gionix38/tevo-bw-pick-and-place/pnp/out/render/bridgeend.png

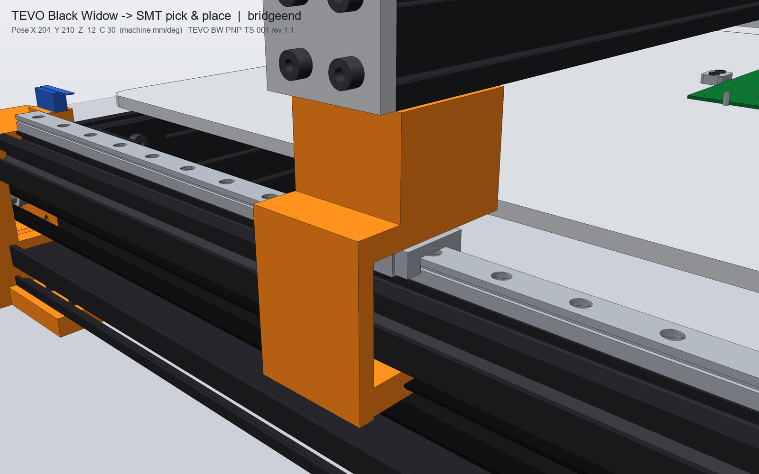
pnp/out/render/bridgeend.png
