gionix38/tevo-bw-pick-and-place/pnp/out/render/front.png

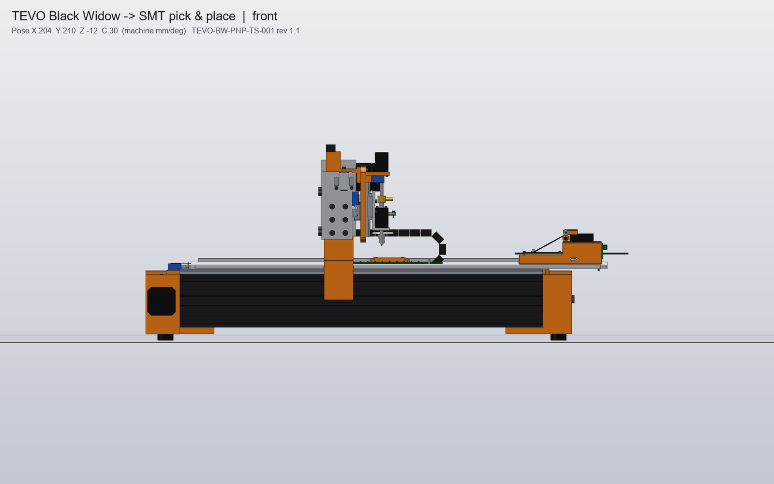
pnp/out/render/front.png
