gionix38/tevo-bw-pick-and-place/docs/i18n/ru/README.md

# Переоборудование TEVO-BW в установщик компонентов

Инженерный проект по переоборудованию 3D-принтера TEVO Black Widow в настольный станок для установки SMT-компонентов. В проект входят параметрические модели FreeCAD, конструкция питателя TBW-Feeder v3.0, инструкции по сборке, предварительные электрические схемы и ведомости материалов (BOM).

> **Состояние проекта:** прототипная конструкция. Проверки CAD и схемы не подтверждают безопасность или работоспособность собранного станка. Перед эксплуатацией проверьте совместимость с реальной рамой, проводку и защиту, пределы перемещения и работу питателя.

## Основные документы

- [Полный иллюстрированный сборник (PDF, 82 страницы)](../../../pnp/out/TEVO_BW_PnP_Dossier.pdf)
- [Руководство по сборке станка](../../../pnp/BUILD_AND_ASSEMBLY.md)
- [Отчёт по текущей CAD-модели](../../../pnp/out/report.md)
- [Архитектура питания и подробная проводка](../../../pnp/electronics/POWER_CONTROL_DESIGN.md)
- [Питатель TBW v3.0](../../../pnp/feeder/README.md)
- [Основная ведомость материалов](../../../pnp/out/bom.csv)

## Состав проекта

- Параметрическая модель станка для FreeCAD и скрипты построения.
- Механическая конструкция портала, головки, рабочего стола и приводов.
- Восьмипозиционный питатель с пошаговой подачей ленты и узлом снятия покровной плёнки.
- Предварительная архитектура питания 24 В, компьютер управления, камеры и контроллеры.
- Сборочные схемы, рендеры, отчёты и предварительные BOM.

## Сборка CAD

Установите FreeCAD 1.1. В PowerShell выполните:

```powershell
cd pnp
.\pnp.ps1 build
.\pnp.ps1 check
.\pnp.ps1 all
```

Проверка модели охватывает заданные положения в CAD, но не подтверждает геометрию реального принтера, электробезопасность или производительность. Для OpenPnP сейчас рекомендуется компьютер x86-64; Raspberry Pi описан как вспомогательный/экспериментальный вариант до проверки ARM64-сборки и работы камер.

Подробные исходные руководства и PDF-сборник пока на английском языке. Этот перевод — краткое описание и указатель по проекту.

## Лицензия и сторонние файлы

Общая лицензия на репозиторий пока не назначена. В отдельных папках находятся сторонние CAD-модели и изображения с отдельными или неясными условиями лицензирования. Перед распространением или коммерческим использованием проверьте происхождение и лицензии этих материалов.
