gionix38/tevo-bw-pick-and-place/pnp/electronics/POWER_CONTROL_DESIGN.md

# TEVO-BW — силовой блок и компьютер управления (концепт A)

Редакция 0.1 · 31.10.2026 · компоновка для текущей модели машины и feeder v3.0

## Решение

- **Основной DC источник:** Mean Well LRS-350-24, 24 V / 14.6 A / 350.4 W, только после сверки фактических токов драйверов, насоса и клапанов. Текущий CAD-проект считает динамику XY для 24 V; это не доказывает, что имеющаяся donor-плата или моторы рассчитаны на такую шину.
- **Компьютер OpenPnP:** x86-64 mini-PC с Linux 64-bit — рекомендуемый производственный host. Официальные OpenPnP Linux packages указывают x86/x64, не ARM64.
- **Raspberry Pi 5:** можно установить Raspberry Pi OS 64-bit Desktop и оставить Pi как вспомогательный компьютер/логгер. Запуск OpenPnP на ARM64 считать экспериментом: он требует сборки/проверки Java-приложения, нативного захвата камер, двух UVC-потоков и USB serial. Orange Pi имеет ту же ARM64 оговорку.
- Host получает отдельное штатное питание. Для Pi 5 это официальный USB-C БП 27 W (5 V / 5 A); не подключать 24 V к GPIO/USB-C и не питать SBC через неизвестный buck.
- **Feeder:** штатный Arduino Nano по USB как отдельный USB/serial-контроллер; сервошина 5 V от собственного DC/DC 24→5 V, не от Pi/Nano/USB. Общий GND логики и сервоприводов соединить одной точкой у feeder controller; исключить обратную подачу питания в USB перемычкой IO-shield.
- **Драйверы движения:** существующая donor-плата и её драйверы, на отдельной защищённой 24 V ветви, если это подтверждено паспортами. Сигналы шаг/направление и E-stop согласовать с фактической платой.

Корпус предусматривает место для Pi 5 как вспомогательной платы, но OpenPnP в производственной конфигурации размещается на x86-64 host. Перенос OpenPnP на Pi/Orange Pi допускается после успешной сборки ARM64 и теста обеих камер, USB-serial motion board/feeder, стабильности изображения и задержки управления.

## Однолинейная схема

```text
230 VAC* → вводной разъём/выключатель → вводная защита → распределительная колодка
                                                   ├─ AC → LRS-350-24 → DC распределитель 24 V
                                                   │                    ├─ предохранитель → motion board / drivers / motors
                                                   │                    ├─ предохранитель → pump (если 24 V) / vacuum valve
                                                   │                    ├─ DC/DC 24→5 V, ≥8 A → servo rail, 8 lanes
                                                   │                    └─ DC/DC 24→5 V, ≥2 A → Nano logic* / sensors (если не USB)
                                                   └─ AC → официальный 27 W USB-C PSU → Raspberry Pi 5

PE ──────────────── корпус/дверь, DIN rail (если проводящий), PE stud БП
E-stop (2 NC контакта) → safety relay/contactor: разрыв 24 V приводов + аппаратный DRIVER_EN
Pi остаётся запитан для логирования; остановка движения не должна зависеть от Linux/OpenPnP.
```

`*` 230 VAC показано как проектное допущение. Проверить местное напряжение, класс защиты источников, разъём, защиту и правила монтажа. Не проводить сетевую часть на печатной плате и не оставлять открытые клеммы. Сетевые работы поручить квалифицированному электрику. PE не коммутировать предохранителем или E-stop. Номинал ввода, автомата, кабеля, контактора, клемм и ответвительных предохранителей выбрать по паспортам нагрузки, способу прокладки и местным нормам; этот документ намеренно не назначает их на глаз.

## DC ветви и расчётный бюджет

| Ветвь | Проектное решение | Проверка до заказа |
|---|---|---|
| 24 V motion | Отдельный fuse holder → фактическая плата и драйверы | Допуск платы/драйверов по входному напряжению; ток и суммарная мощность; фактическая PSU машины (в проекте WP0) |
| 24 V vacuum | Отдельная ветвь для насоса и нормально закрытого клапана | Паспортный пусковой ток насоса, duty cycle клапана, диод/TVS катушки по её паспорту |
| 5 V servo | DC/DC 5 V, не менее 8 A, с тепловым запасом; звезда к шине servo | Измерить пиковый ток одного серво и худший одновременный сценарий 8 дорожек; проверить просадку на дальнем servo |
| 5 V feeder logic | Nano питается по USB во время настройки; при автономном питании — выделенный защищённый DC/DC | На IO shield не соединять USB 5 V с внешней сервошиной; сверить схему конкретного shield |
| Pi 5 | Производитель рекомендует питание 5 V / 5 A и адаптер 27 W; штатный USB-C PSU | Две камеры, SSD, fan и USB hub: проверить сообщения undervoltage, ток и пропускную способность |

LRS-350-24 даёт 24×14.6 = **350.4 W** на выходе по паспорту; это предельный источник, не утверждение о потреблении машины. Сложить измеренные токи всех одновременно работающих ветвей, учесть пуск насоса и запас, после чего подобрать защиту каждой ветви и сечение. Предусмотреть не менее 20% резерва по длительной нагрузке как проектную цель; подтвердить тепловым тестом в закрытом корпусе. В текущем проекте feeder-заметка оценивает сервошину приблизительно до 1.1 A, но это прежняя оценка для одного активного серво и лёгкого удержания, а не гарантированный all-servo stall current.

## Корпус и компоновка

Предлагаемый монтажный щит **300×240×120 mm** (Ш×В×Г), IP20 внутри сухого закрытого основания станка. Перед изготовлением проверить реальные габариты LRS-350, доступ к винтам/клеммам, радиус изгиба и выделение тепла по паспорту конкретной партии. Металлический корпус предпочтителен как защитный экран; отдельная PE шпилька с шайбами-зубцами, провод двери/крышки. Пластиковый корпус требует закрытых клемм и отдельного решения по защите от прикосновения и пожара.

Зоны: сверху/слева — ввод AC и 24 V PSU; справа — защищённые DC клеммы и DC/DC; низ — PE и вводы кабеля; Pi в отдельном вентилируемом низковольтном отсеке, удалённом от 230 V и силовых моторов/драйверов. Сервошина и USB-кабели вести отдельно от моторных фаз и насоса; пересекать силовые провода под 90°. Поставить strain relief на вводах. Не ставить Pi поверх PSU/драйвера и не закрывать радиатор/активный cooler.

В комплекте находятся векторные эскизы `power_wiring.svg` и `enclosure_layout.svg`, их PNG-экспорты и редактируемый источник `render_concept.ps1`. Это концептуальные схемы/рендер компоновки, не производственный чертёж с допусками. Корпус не смоделирован в исходном FreeCAD assembly.

Подробная клеммная схема AC/PE/24 V, аварийного останова и DC/DC дана в [`WIRING_DETAILS.md`](WIRING_DETAILS.md) и `wiring_detail.svg` / `wiring_detail.png`. USB, host, камеры и распиновка Nano/servo показаны в `host_io_detail.svg` / `host_io_detail.png`. Процедура установки ОС и совместимость ПО вынесены в [`PI5_SOFTWARE.md`](PI5_SOFTWARE.md).

## Пуск и приёмка

1. Записать фото шильдиков фактической платы, драйверов, PSU, насосов, клапанов, световых колец и камер. Сверить 12/24 V до подключения.
2. С отключённой нагрузкой настроить DC/DC; измерить 24.0 V и 5.0 V на выводах нагрузки. Ограничить ток и проверить полярность.
3. Подключить только motion board; проверить E-stop аппаратно: DRIVER_EN снимается, силовая ветвь приводов отключается, Pi остаётся online.
4. Проверить Nano/servo отдельно: внешний 5 V, правильный jumper, просадку при feed всех lane, нагрев buck и кабелей.
5. На Pi установить целевой OpenPnP и провести длительный тест обеих камер, motion serial, feeder serial, USB и логирования. Записать версию ОС, OpenPnP, camera driver, latency и ошибки.
6. 30 минут при максимальном расчётном цикле: измерить температуры PSU/DC/DC/контактора, напряжения на дальнем servo и SBC; любой brownout, перегрев или сброс означает остановку и пересмотр проекта.

## Что ещё не подтверждено

- Идентичность и входное напряжение donor motherboard/stepper drivers.
- Точные токи моторов, вакуумного насоса, клапанов, кольцевого света, камер и всех сервоприводов.
- Совместимость выбранного SBC/ОС с OpenPnP и захватом обеих камер.
- Размещение корпуса и крепёж к реальной раме, вентиляция/температура, EMC и электрическая безопасность.
- Уставки защит, номиналы проводов/предохранителей, пригодность E-stop и safety relay.

## Источники

- [Mean Well LRS-350 datasheet](https://www.meanwell.com/Upload/PDF/LRS-350/LRS-350-SPEC.PDF) — выходные параметры и требования к охлаждению/монтажу.
- [Raspberry Pi 5 product brief](https://datasheets.raspberrypi.com/rpi5/raspberry-pi-5-product-brief.pdf) и [официальные рекомендации по питанию](https://www.raspberrypi.com/documentation/computers/getting-started.html).
- [OpenPnP camera setup](https://github.com/openpnp/openpnp/wiki/Setup-and-Calibration_General-Camera-Setup) — проверить конкретную сборку и драйвер на целевой ARM64 ОС.
