gionix38/tevo-bw-pick-and-place/pnp/out/report.md

# TEVO-BW PnP - model report

Generated by `pnp build` from `params.py`. Spec: TEVO-BW-PNP-TS-001 rev 1.1. Date: 2026-10-24 17:36.

## Envelope (TS 3, 7.1, 7.2)

| Quantity | Value |
| --- | --- |
| Frame footprint (C-beams, without drive blocks) | 574 x 560 mm |
| C-beam inner gap (measured in stock STEP) | 480 mm |
| X travel (bridge on MGN12, 10 mm rail margin) | 453.0 mm |
| Y travel (carriage on MGN12, 10 mm rail margin) | 382.6 mm |
| Z stroke / usable (FR-11 >= 35) | 40 / 35 mm |
| Z soft limit (tip 1.0 mm into compliance at PCB top) | -37.4 mm |
| Bridge beam underside | Z 153 mm (frame) |
| Table top / PCB top | Z 114.0 / 115.6 mm (frame) |
| Nozzle tip at Z home | Z 152.0 mm (frame) |
| Machine origin (nozzle home) in frame coords | (114.0, 88.7, 152.0) |

## Steps per unit (TS 8.1)

| Axis | Value |
| --- | --- |
| X, Y (GT2, 20T, 1/16) | 80.000 steps/mm |
| Z (T5x2 lead 2, 1/4) | 400.0 steps/mm |
| C (1:1, 1/16) | 8.8889 steps/deg |

## Carriage mass budget (FR-4, <= 500 g)

| Part | Group | Mass g |
| --- | --- | ---: |
| Head_Carriage | carriage | 106.6 |
| ZMotor_NEMA8_LIN30 | carriage | 60.0 |
| CMotor_NEMA8_HOLLOW30 | zslide | 60.0 |
| YBlock_A | carriage | 37.0 |
| YBlock_B | carriage | 37.0 |
| ZRail_MGN9 | carriage | 34.2 |
| ZBlock_MGN9H | zslide | 26.0 |
| Z_Slide | zslide | 25.1 |
| Head_BeltClamp | carriage | 21.7 |
| Camera_Angle | carriage | 18.8 |
| ZScrew_T5x2 | carriage | 13.9 |
| DownCam_Board | carriage | 10.0 |
| Vacuum_Swivel | zslide | 10.0 |
| DownCam_Lens_M12 | carriage | 8.0 |
| DownCam_LEDRing | carriage | 6.0 |
| ZNut_T5x2_Flange | zslide | 5.0 |
| Hollow_Shaft | rotor | 4.7 |
| DownCam_LensHolder | carriage | 4.0 |
| Juki_Holder | rotor | 3.3 |
| ZHome_Switch | carriage | 3.0 |
| Compliance_Sleeve | rotor | 2.7 |
| Nozzle_Tip_loaded | rotor | 1.5 |
| **Total moving in Y** | | **499** |
| Total without the two MGN12H blocks | | 425 |

Status: **PASS** (Z motor NEMA8_LIN30). With the stock NEMA17 40 mm on Z the total is 719 g (+220 g).
Purchased-part masses are catalogue typicals; printed parts use PETG 1.27 g/cm3 x 70% effective fill. WP4 step 6 weighs the real head.

## Reach (machine coordinates)

Nozzle reach: X 114.0..567.0, Y 88.7..471.3 (frame).

| Target | X, Y | Reachable |
| --- | --- | --- |
| lane 1 pick | 426.0, 62.5 | yes |
| lane 2 pick | 426.0, 84.5 | yes |
| lane 3 pick | 426.0, 106.5 | yes |
| lane 4 pick | 426.0, 128.6 | yes |
| lane 5 pick | 426.0, 150.6 | yes |
| lane 6 pick | 426.0, 172.6 | yes |
| lane 7 pick | 426.0, 194.6 | yes |
| lane 8 pick | 426.0, 216.6 | yes |
| magazine pocket 1 | 434.0, 288.3 | yes |
| magazine pocket 2 | 434.0, 306.3 | yes |
| magazine pocket 3 | 434.0, 324.3 | yes |
| magazine pocket 4 | 434.0, 342.3 | yes |
| magazine pocket 5 | 434.0, 360.3 | yes |
| magazine pocket 6 | 434.0, 378.3 | yes |
| up camera | 434.0, 249.3 | yes |
| PCB front-left | 136.0, 161.3 | yes |
| PCB rear-right | 296.0, 261.3 | yes |
| PCB area 200x150 far corner | 336.0, 311.3 | yes |
| down camera over lane 1 pick | 424.0, 5.5 | yes |
| down camera over lane 8 pick | 424.0, 159.6 | yes |

## Z heights (machine Z, 0 = home switch)

Lowest tip (soft limit): Z -37.4. Lowest fixed head part at home: frame Z 146.0; tallest tooling the head passes over (X < 592, feeder towers excluded): frame Z 140.8; clearance 5.2 mm.

| Operation | Z needed | Reachable with >= 1 mm margin |
| --- | ---: | --- |
| place on PCB (top) | -36.4 | yes |
| pick from tape pocket | -22.6 | yes |
| magazine engage height | -22.0 | yes |
| up-camera hover (4 mm above ring) | -31.5 | yes |

## Dynamics (PR-1..PR-4, PR-10)

Moving mass: X (bridge + head) 3.08 kg, Y (head) 0.50 kg. Profiles use catalogue kg/m (WP0 weighs the beam); motors are the stock NEMA17 40 mm, 24 V supply, required margin 2.0 on pull-out torque.

| Check | Result | Pass |
| --- | --- | --- |
| X drive: 3.08 kg at 3000 mm/s2, 400 mm/s (600 rpm) | need 0.088 N m, pull-out 0.252 N m, margin 2.9 | yes |
| X step rate at 400 mm/s | 32000 steps/s (board 40000) | yes |
| Y drive: 0.50 kg at 4000 mm/s2, 400 mm/s (600 rpm) | need 0.042 N m, pull-out 0.252 N m, margin 6.1 | yes |
| Y step rate at 400 mm/s | 32000 steps/s (board 40000) | yes |
| Z step rate at PR-3 60 mm/s (1/4, 400 steps/mm) | 24000 steps/s, board limit gives 100 mm/s | yes |
| Z drive NEMA8_LIN30 travel (slide 0.14 kg, 1500 mm/s2): 1.6 N at 1800 rpm | need 0.0014 N m, pull-out 0.0045 N m, margin 3.2 | yes |
| Z drive NEMA8_LIN30 contact (slide weight + 1.5 N compliance, slow): 2.9 N at 300 rpm | need 0.0026 N m, pull-out 0.0144 N m, margin 5.5 | yes |
| C step rate, 90 deg in 150 ms (PR-4) | 10667 steps/s peak | yes |
| PR-10 cycle estimate (avg lane -> up camera -> PCB centre -> back) | 4.97 s/part = 724 parts/h (814 with the feed done during the place) | **NO** |

Cycle breakdown: XY 1.71 s, Z 2.34 s (at 60 mm/s, from Safe Z), vision 0.25 s, vacuum 0.12 s, feed 0.55 s. **OpenPnP Safe Z = -9.2** (machine Z: tip 2 mm above the tallest tooling the head passes over). Moving between pick, camera and place at Safe Z instead of Z 0 is what makes PR-10.

## Interference check

No interference between moving and fixed parts at the checked poses.

## Custom parts (what has to be made)

| Part | Kind | Qty | Mass each g |
| --- | --- | ---: | ---: |
| Down camera angle, Al 3 mm, slotted for focus | machined | 1 | 19 |
| Nozzle magazine bar, Al 24x12, 6 pockets along Y | machined | 1 | 79 |
| Tooling plate Al 6 mm 635 x 444, PCB area + tooling strip (one piece) | machined | 1 | 4504 |
| X chain tray, Al angle 50x18x2, 495 mm | machined | 1 | 176 |
| Y idler bracket, machined Al (end plate + side flange + slotted cheeks) | machined | 1 | 140 |
| Y motor bracket, machined Al 6 mm (end plate + motor plate + side flange + gussets) | machined | 1 | 225 |
| Y tension block, steel 7x10x12, M3 tapped | machined | 2 | 9 |
| Z slide, one piece: block plate + C motor arm + nut seat (CNC Al 6061) | machined | 1 | 25 |
| Bridge end: foot + riser + belt clamp (printed PETG-CF, 100% infill) | printed | 2 | 86 |
| Corner block front-left with X motor mount (printed PETG/ASA) | printed | 1 | 325 |
| Corner block front-right (printed PETG/ASA) | printed | 1 | 179 |
| Corner block rear-left (printed PETG/ASA) | printed | 1 | 199 |
| Corner block rear-right (printed PETG/ASA) | printed | 1 | 179 |
| Cover tape waste bin (printed PETG) | printed | 1 | 27 |
| Empty-tape exit chute, 8 lanes (printed PETG) | printed | 1 | 48 |
| Feeder v3.0 cover plate, bayonet rails (printed PETG) | printed | 8 | 1 |
| Feeder v3.0 cover tape guide bar D2.9 with head, pushed into the post (printed PETG) | printed | 8 | 0 |
| Feeder v3.0 idler gear 36T m1 with axle stub (printed PETG) | printed | 8 | 2 |
| Feeder v3.0 main body (printed PETG) | printed | 8 | 35 |
| Feeder v3.0 pawl, feed + detent (printed PETG) | printed | 16 | 0 |
| Feeder v3.0 pinch axle D6 x 14, pressed into the yoke (printed PETG) | printed | 8 | 0 |
| Feeder v3.0 pinch yoke (printed PETG) | printed | 8 | 0 |
| Feeder v3.0 pinion 14T m1 with the D6 drive shaft, one part (printed PETG) | printed | 8 | 1 |
| Feeder v3.0 rack m1 on the slider (printed PETG) | printed | 8 | 0 |
| Feeder v3.0 roller body, drive + pinch (printed PETG) | printed | 16 | 1 |
| Feeder v3.0 servo gear sector 13T m1 on the spline (printed PETG, replaces the horn) | printed | 8 | 0 |
| Feeder v3.0 side plate (printed PETG) | printed | 8 | 13 |
| Feeder v3.0 slider (printed PETG) | printed | 8 | 4 |
| Head belt clamp + Y chain post (printed PETG-CF) | printed | 1 | 22 |
| Head carriage plate: block mount + Z rail + Z motor shelf (printed PETG-CF) | printed | 1 | 107 |
| PCB slide clamp (printed PETG) | printed | 1 | 9 |
| Reel hub / spacer (printed PETG) | printed | 8 | 4 |
| Reel rack side plate (printed PETG) | printed | 2 | 20 |
| Up camera housing, one piece (printed PETG) | printed | 1 | 25 |
| Waste bin leg (printed PETG) | printed | 2 | 3 |
| X chain arm (printed PETG), on the Y motor bracket | printed | 1 | 8 |
| X chain tray bracket (printed PETG) | printed | 3 | 22 |
| X idler tension slider (printed PETG) | printed | 2 | 5 |

150 printed + 9 machined parts; 411 fasteners (see bom.csv, kind = fastener).

## Printing (printed parts)

All printed parts are orange PETG (PETG-CF for the head parts). STLs in `parts_stl/` are already turned to the print orientation below and lie on Z = 0. Horizontal holes over 5.2 mm diameter have a 45 deg teardrop roof (no support). Settings: 0.2 mm layers, 4 perimeters, 5 top/bottom layers, 40% gyroid, elephant-foot compensation 0.2 mm, no supports. Bed check: 220 x 220 x 250 mm.

| Part | Qty | Orientation (bed face) | Size on bed mm | Bed contact mm2 | Overhang mm2 | Flat bridge mm2 | Teardrops | Fits |
| --- | ---: | --- | --- | ---: | ---: | ---: | ---: | --- |
| Corner_FrontLeft | 1 | +Z up (as installed) | 104 x 104 x 96 | 8557 | 0 | 596 | 29 | yes |
| Corner_RearLeft | 1 | +Z up (as installed) | 104 x 68 x 90 | 6685 | 0 | 596 | 22 | yes |
| Corner_FrontRight | 1 | +Z up (as installed) | 100 x 68 x 90 | 6413 | 0 | 610 | 15 | yes |
| Corner_RearRight | 1 | +Z up (as installed) | 100 x 68 x 90 | 6413 | 0 | 610 | 15 | yes |
| XIdler_Slider_Front | 2 | +Z up (as installed) | 22 x 21 x 28 | 161 | 0 | 0 | 0 | yes |
| Bridge_End_Front | 2 | on the -X face | 91 x 64 x 44 | 2567 | 0 | 0 | 12 | yes |
| XChain_Arm | 1 | on the -Y face | 28 x 17 x 56 | 371 | 8 | 0 | 0 | yes |
| Head_Carriage | 1 | on the -X face | 114 x 128 x 44 | 14446 | 0 | 0 | 1 | yes |
| Head_BeltClamp | 1 | on the -Y face | 52 x 47 x 24 | 1037 | 0 | 0 | 0 | yes |
| PCB_SlideClamp | 1 | +Z up (as installed) | 60 x 30 x 8 | 1683 | 0 | 0 | 0 | yes |
| UpCam_Housing | 1 | +Z up (as installed) | 48 x 48 x 42 | 2240 | 0 | 36 | 0 | yes |
| Lane*_Body | 8 | on the +Y face | 127 x 66 x 20 | 4142 | 0 | 88 | 0 | yes |
| Lane*_SidePlate | 8 | on the -Y face | 127 x 61 x 16 | 3385 | 0 | 149 | 0 | yes |
| Lane*_CoverPlate | 8 | +Z up (as installed) | 62 x 18 x 10 | 973 | 0 | 0 | 0 | yes |
| Lane*_Slider | 8 | +Z up (as installed) | 85 x 14 x 17 | 619 | 0 | 31 | 0 | yes |
| Lane*_Pawl_1 | 16 | on the -Y face | 12 x 8 x 2 | 48 | 0 | 0 | 0 | yes |
| Lane*_ServoGear | 8 | +Z up (as installed) | 11 x 12 x 5 | 68 | 0 | 10 | 0 | yes |
| Lane*_Rack | 8 | on the -Y face | 15 x 12 x 3 | 142 | 0 | 17 | 0 | yes |
| Lane*_Idler | 8 | on the +Y face | 38 x 38 x 4 | 999 | 0 | 0 | 0 | yes |
| Lane*_Pinion | 8 | on the -Y face | 16 x 16 x 18 | 136 | 0 | 0 | 0 | yes |
| Lane*_DriveRoller | 16 | on the -Y face | 15 x 15 x 12 | 102 | 0 | 0 | 0 | yes |
| Lane*_PinchAxle | 8 | on the -Y face | 6 x 6 x 14 | 28 | 0 | 0 | 0 | yes |
| Lane*_PinchYoke | 8 | +Z up (as installed) | 18 x 15 x 14 | 160 | 0 | 0 | 1 | yes |
| Lane*_GuideBar | 8 | on the -Y face | 6 x 6 x 18 | 26 | 0 | 0 | 0 | yes |
| Feeder_ExitChute | 1 | on the -Y face | 21 x 17 x 178 | 325 | 4 | 258 | 5 | yes |
| Feeder_WasteBin | 1 | +Z up (as installed) | 36 x 198 x 28 | 7011 | 0 | 12 | 0 | yes |
| Feeder_WasteBinLeg_1 | 2 | on the -X face | 43 x 10 x 8 | 430 | 0 | 0 | 0 | yes |
| ReelRack_Side_1 | 2 | on the -Y face | 120 x 107 x 8 | 2827 | 0 | 0 | 0 | yes |
| ReelHub_1 | 8 | on the +Y face | 22 x 22 x 22 | 323 | 0 | 0 | 0 | yes |
| XChain_TrayBracket_1 | 3 | on the -X face | 80 x 54 x 20 | 1258 | 0 | 0 | 1 | yes |

Flat bridges left: corner-block pocket roofs (8 mm flat between 45 deg chamfers), down-facing counterbores under the feet, feeder body slider tunnel (5 / 13 mm) and pinch-yoke pocket (3.3 mm). All are within normal PETG bridging. Feeder waste bin is printed upside down; its floor bridges 34 mm.

## Design notes against the TS

- **D1** The stock C-beams are 480 mm apart (inner faces) in `Tevo Black Widow assembly.step`, not 500. The 20x80x500 top tie sits on the C-beam ends and does not fit between them; it is cut to 480. WP0 confirms.
- **D2** In the project model the 40x80x550 extrusion is the bed (Y) axis beam; the stock X gantry is two 20x40x485 bars. This model uses the 40x80x550 as the Y bridge (TS 4 item 2) and the 20x40 pair, cut to 480, as the second tie (TS 7.1).
- **D3** The bridge sits on 32 mm risers so the beam underside (Z 153) clears the tape bank, magazine and clamps. The head hangs in front of the beam (+X), so the nozzle reach is offset by 65.0 mm in X.
- **D4** The X belts run inside the open C channels; the C-beam end caps are replaced by printed drive and idler blocks. The jackshaft sits at the left end (TS 7.1).
- **D5** Head Z motor defaults to NEMA8_LIN30 to cut mass; the stock NEMA17 is the fallback named in WP4 step 6.
- **D6 (rev B)** The 20x80x210 legs are gone. Four printed corner blocks are end cap, pulley/idler housing, jackshaft bearing seat (608ZZ pressed in), tie corner bracket and leg in one; the front-left one also holds the X motor. Rubber feet screw into them.
- **D7 (rev B)** Tape lanes, up camera and nozzle magazine sit in a strip right of the bridge travel (X > 526, beam right face at most X 522), so the beam never passes over them. Tapes feed in from the right end. Magazine pockets run along Y (TS 7.5 says along X; the change is still single-axis motion).
- **D8 (rev B)** One tooling plate carries the PCB fixture and the whole tooling strip, so all feeder, camera and magazine coordinates share one datum. 3-point support: left tie + two posts on the right tie.
- **D9 (rev B)** Head = one printed head carriage (mother plate, head plate, Z motor bracket, camera bracket, switch arm, belt clamp, chain post) + one machined Z slide (Z plate, both bearing bores in one setup for FR-14, nut seat, C motor shelf). Bridge = one printed end per side (foot plate, riser, belt clamp, chain arm). The LP mother plate is no longer used.
- **D10 (rev B)** Vacuum panel and electronics box are not modelled for now; TS 7.4 and 8 still apply.
- **D11 (rev D, current head)** The head uses a NEMA8 hollow-shaft C motor and a NEMA8 external linear Z motor with integral T5x2 screw. The nozzle stack is approximately 15 g; bearing runout and loaded repeatability must be measured on the selected motor. Weigh the assembled head and verify motor torque at the actual supply voltage before setting acceleration.
- **D12 (superseded feeder history)** The v2.0/v2.1 lane used a flexure pawl and ratchet-based peel mechanism and is archived under `legacy/feeder_v2.1/`. It is not the current geometry. Current feeder details are D14 and `feeder/ASSEMBLY.md`.
- **D13 (rev F, dynamics)** (1) Aluminium profiles now carry catalogue kg/m instead of the solid-core model volume: the bridge beam was 3.6 kg in the model, ~1.3 kg in reality, so X moves 3.08 kg, not ~5.3 kg. (2) Z runs at 1/4 microstepping (400 steps/mm, 2.5 um): at 1/16 PR-3 needs 96k steps/s, over the ~40k of the 8-bit board. Configure the Z driver jumpers and Marlin DEFAULT_AXIS_STEPS_PER_UNIT to match. (3) OpenPnP Safe Z = -9.2 (tip 2 mm over the tallest tooling in reach, the magazine tips); travel at Safe Z is checked in `pnp check`. Together they bring the PR-10 estimate from ~610 to ~724 parts/h. (4) The torque checks assume a 24 V supply; at 12 V the X margin drops to ~1.9 (WP0 confirms).
- **D14 (current v3.0 feeder)** Eight independent servo lanes use a rigid spring-loaded feed pawl and detent, plus a rack/idler/pinion peel drive with two HF0612 one-way bearings per lane. The segmented cover plate is screw-locked; lane body and side plate split so PETG parts print without supports. One separate Nano controller runs the servos. This geometry is awaiting its documented physical first article; see `feeder/README.md` and `feeder/TEST.md`.
