gionix38/tevo-bw-pick-and-place/docs/i18n/PROJECT_DESCRIPTION.md

# GitHub project description

Use one of these short descriptions in the GitHub repository **About** field:

- **English:** Open CAD and build documentation for converting a TEVO Black Widow into a desktop SMT pick-and-place machine.
- **Русский:** Открытая CAD-модель и документация по переоборудованию TEVO Black Widow в настольный станок для установки SMT-компонентов.
- **Português (Brasil):** Modelos CAD e documentação para converter uma TEVO Black Widow em uma máquina pick-and-place SMT de bancada.
- **简体中文:** 将 TEVO Black Widow 改装为桌面 SMT 贴片机的开放 CAD 模型与装配文档。

Suggested repository name: `tevo-bw-pick-and-place`.
