gionix38/tevo-bw-pick-and-place/pnp/feeder/out/audit.md

# TBW-Feeder v3.0 audit

Generated by `feeder audit` on 2026-10-24 17:59.

| Area | Check | Result | Status | Note |
|---|---|---|---|---|
| geometry | static overlaps, all 30 lane parts + tape (model pose = forward end) | none | OK | press fits are modelled line-on-line |
| geometry | feed pawl and detent teeth sit in sprocket holes at the forward end | 0.000 / 0.000 mm3 | OK | detent hook face 0.15 mm behind its hole edge (back-drag play) |
| advance | servo sweep 71.5..108.5 deg (9 poses): servo gear, slider, pawl, rack, idler, pinion vs every part | free (39 pairs) | OK | rack, idler and pinion in mesh over the whole stroke; the pawl riding under the tape is checked below |
| advance | feed tooth drops into the next hole at the retract end | tooth/tape 0.000 mm3 | OK | stroke 4.2 = 4.0 feed + 0.2 free travel |
| peel | rack/idler and idler/pinion engaged at both stroke ends (moved 0.6 mm into mesh they overlap) | 2.11 / 1.51, 1.02 / 1.17 mm3 | OK |  |
| advance | feed pawl rides over: tooth 0.85 mm down (5.8 deg about the pin) / up-stop | free (0.000 mm3) / stop hit (0.11 mm3 at +0.6 deg) | OK | the tail sits on the fork floor, so the push load (self-locking) cannot lift the tooth further |
| advance | detent rides over: tooth 0.85 mm down (5.8 deg about the pin) / up-stop | free (0.000 mm3) / stop hit (0.11 mm3 at +0.6 deg) | OK | the tail sits on the fork floor, so the push load (self-locking) cannot lift the tooth further |
| peel | pinch yoke pushed down 3 mm by its rear tab (thread the cover tape) | free | OK |  |
| assembly | lay-in assembly paths (8), reverse order of ASSEMBLY.md (screws go in along their axis) | all free | OK | one direction for everything; then 3 side plate screws, the guide bar and the 2 cover plate screws |
| cover | bayonet cover plate: held at home / slides 6.8 mm to the pick side / lifts off | held / free / free | OK | 3 rail segments per side + 2 rear tongues; 2 M2 screws lock it |
| printing | Body on the +Y face: bridge / one-sided ceiling / steep overhang | 8.8 mm / 1.0 mm / 0.0 mm2 | OK | no supports: limits 10 / 1 / 3; 127 x 66 x 21 mm, bed contact 4142 mm2 |
| printing | Body thinnest wall (X/Y line sampling) | 0.90 mm at ('Y', 535.25, 9.3, 16.9) | OK |  |
| printing | SidePlate on the -Y face: bridge / one-sided ceiling / steep overhang | 6.3 mm / 1.0 mm / 0.0 mm2 | OK | no supports: limits 10 / 1 / 3; 127 x 61 x 16 mm, bed contact 3384 mm2 |
| printing | SidePlate thinnest wall (X/Y line sampling) | 0.85 mm at ('Y', 602.25, 4.7, 14.4) | OK |  |
| printing | CoverPlate +Z up (as installed): bridge / one-sided ceiling / steep overhang | 0.0 mm / 0.0 mm / 0.0 mm2 | OK | no supports: limits 10 / 1 / 3; 62 x 18 x 10 mm, bed contact 973 mm2 |
| printing | CoverPlate thinnest wall (X/Y line sampling) | 1.20 mm at ('Y', 588.25, -9.3, 24.2) | OK |  |
| printing | Slider +Z up (as installed): bridge / one-sided ceiling / steep overhang | 3.4 mm / 0.9 mm / 0.0 mm2 | OK | no supports: limits 10 / 1 / 3; 85 x 14 x 17 mm, bed contact 619 mm2 |
| printing | Slider thinnest wall (X/Y line sampling) | 0.80 mm at ('X', 556.3, 147.55, 8.6) | OK |  |
| printing | Pawl on the -Y face: bridge / one-sided ceiling / steep overhang | 0.0 mm / 0.0 mm / 0.0 mm2 | OK | no supports: limits 10 / 1 / 3; 12 x 8 x 2 mm, bed contact 48 mm2 |
| printing | Pawl thinnest wall (X/Y line sampling) | 0.84 mm at ('X', 557.4, 148.1, 15.3) | OK |  |
| printing | ServoGear +Z up (as installed): bridge / one-sided ceiling / steep overhang | 3.6 mm / 1.0 mm / 0.0 mm2 | OK | no supports: limits 10 / 1 / 3; 11 x 12 x 5 mm, bed contact 68 mm2 |
| printing | ServoGear thinnest wall (X/Y line sampling) | 2.11 mm at ('X', 606.5, 149.75, 21.7) | OK |  |
| printing | Rack on the -Y face: bridge / one-sided ceiling / steep overhang | 0.0 mm / 0.6 mm / 0.0 mm2 | OK | no supports: limits 10 / 1 / 3; 15 x 12 x 3 mm, bed contact 142 mm2 |
| printing | Rack thinnest wall (X/Y line sampling) | 1.13 mm at ('X', 626.4, 144.05, 8.7) | OK |  |
| printing | Idler on the +Y face: bridge / one-sided ceiling / steep overhang | 0.0 mm / 0.0 mm / 0.0 mm2 | OK | no supports: limits 10 / 1 / 3; 38 x 38 x 4 mm, bed contact 999 mm2 |
| printing | Idler thinnest wall (X/Y line sampling) | 1.03 mm at ('X', 631.2, 140.55, 37.2) | OK |  |
| printing | Pinion on the -Y face: bridge / one-sided ceiling / steep overhang | 0.0 mm / 0.0 mm / 0.0 mm2 | OK | no supports: limits 10 / 1 / 3; 16 x 16 x 18 mm, bed contact 136 mm2 |
| printing | Pinion thinnest wall (X/Y line sampling) | 1.35 mm at ('X', 635.0, 144.05, 58.9) | OK |  |
| printing | DriveRoller on the -Y face: bridge / one-sided ceiling / steep overhang | 0.0 mm / 0.0 mm / 0.0 mm2 | OK | no supports: limits 10 / 1 / 3; 15 x 15 x 12 mm, bed contact 103 mm2 |
| printing | DriveRoller thinnest wall (X/Y line sampling) | 0.83 mm at ('Y', 635.65, 1.3, 51.8) | OK |  |
| printing | PinchAxle on the -Y face: bridge / one-sided ceiling / steep overhang | 0.0 mm / 0.0 mm / 0.0 mm2 | OK | no supports: limits 10 / 1 / 3; 6 x 6 x 14 mm, bed contact 28 mm2 |
| printing | PinchAxle thinnest wall (X/Y line sampling) | 2.99 mm at ('X', 636.5, 144.65, 40.3) | OK |  |
| printing | PinchYoke +Z up (as installed): bridge / one-sided ceiling / steep overhang | 0.0 mm / 0.0 mm / 0.0 mm2 | OK | no supports: limits 10 / 1 / 3; 18 x 15 x 14 mm, bed contact 160 mm2 |
| printing | PinchYoke thinnest wall (X/Y line sampling) | 1.25 mm at ('X', 633.8, 156.25, 42.4) | OK |  |
| printing | GuideBar on the -Y face: bridge / one-sided ceiling / steep overhang | 0.0 mm / 0.0 mm / 0.0 mm2 | OK | no supports: limits 10 / 1 / 3; 6 x 6 x 18 mm, bed contact 26 mm2 |
| printing | GuideBar thinnest wall (X/Y line sampling) | 2.10 mm at ('X', 595.2, 143.2, 48.4) | OK |  |
| printing | printed lane parts: material / count / filament | PETG / 15 parts (13 different) / 59 g | OK | one material, one 0.4 mm nozzle; no TPU (O-rings are bought) |
| loads | pawl spring (steel, OD 3 x 0.3 x L0 8, ~0.5 N/mm): seated / riding over | 1.25 / 1.56 N | OK | solid length ~3 mm; the v2.1 flexure pawl gave 0.26 N |
| loads | pawl pivot below the tooth: the push load turns the tooth deeper (self-locking) | contact 5.9 mm above the pivot | OK | positive up-stop: the tail on the fork floor |
| loads | tape push (detent ramp + pawl friction + reel drag) / servo torque vs SG90 stall 0.18 N m | 3.8 N / 0.0244 N m | OK |  |
| loads | pawl tooth root bending (0.8 x 1.15 root, load 0.5 above it; prints lying, in-plane) | 10.7 MPa | OK | PETG ~45 MPa in the layer plane |
| loads | pinch spring / nip slip tension (NBR O-rings, mu ~0.8) | 1.50 / 1.20 N | OK | EIA-481 peel force 0.1..1.3 N |
| peel | cover tape tension held on the idle stroke (pinch roller with O-rings, locked by its HF0612) | 1.20 N | OK | = nip slip tension, so the cover tape does not slip back on the retract |
| peel | drive roller surface per full stroke (4 mm fed) / half stroke (2 mm fed) | 4.80 / 2.40 mm | OK | rack 4.2 x R 8 / R 7 (the 38T idler doesn't change it), less 0.31 mm backlash + clutch take-up; the surplus slips in the nip |
| loads | servo torque, tape + peel at nip slip vs stall 0.18 N m | 0.0343 N m (peel adds 1.5 N at the slider) | OK | the v3.0 lifter slot added 3.1 N |
| loads | pinion / idler / rack tooth bending (Lewis, 14T m1, face 1.8) | 2.8 MPa | OK | the v2.1 ratchet teeth were 0.6 mm deep |
| loads | pinion shaft (printed with the pinion, D6, bored D3.3 at the -y end) in torsion | 10 N mm, 0.25 MPa | OK | PETG creep limit ~5 MPa; no press fit left to slip |
| loads | HF0612 one-way bearings: torque / catalogue rating | 10 / ~1800 N mm | OK | on printed PETG shafts (the catalogue assumes HRC 58): TEST A10 checks the lock |
| cover | cover plate deflection under the pawl spring: rails every 14 mm vs v2.1 (screws + hinge 58 mm apart) | 0.031 mm vs 2.2 mm | OK | the v2.1 plate bowed enough to let the pawl lift the tape out of the hole |
| cover | 2 x M2 countersunk screws (self-tapped into PETG, ~40 N pull-out each) lock the plate home vs tape drag on the feed stroke | 80 N vs 0.94 N | OK | the bayonet cannot slide out while they are in: positive lock, no magnets |
| bank | chute, waste bin, reel rack vs frame, plate, lanes | none | OK |  |
| bank | empty tape drop path below the plate slot to the bench | clear | OK |  |
| bank | carrier tape path reel -> lane inlet | clear | OK |  |
| bank | used cover tape leaves the nip over the waste bin lip | clear | OK |  |

**54 OK, 0 FAIL**
