gionix38/tevo-bw-pick-and-place/pnp/electronics/enclosure_render.png

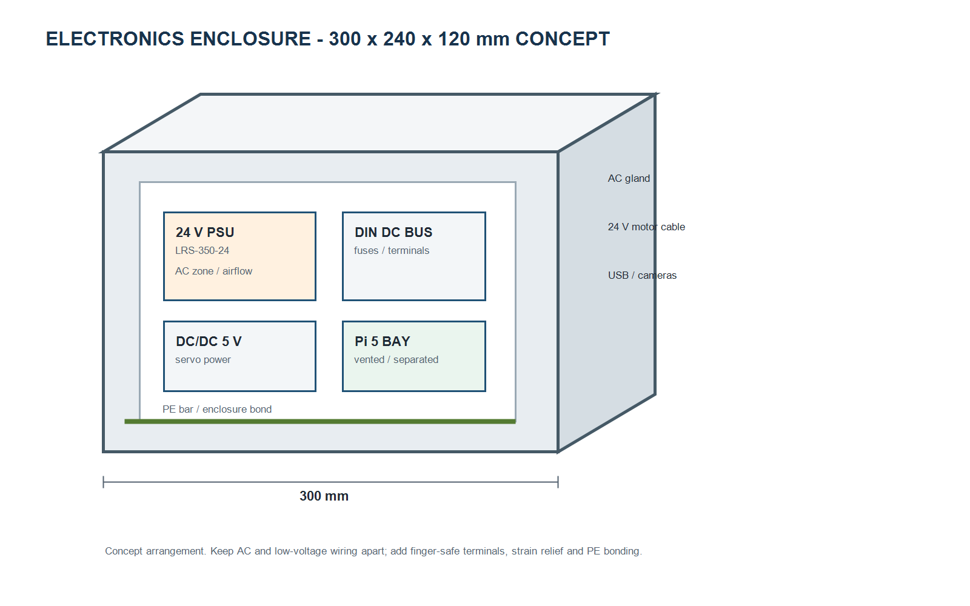
pnp/electronics/enclosure_render.png
