gionix38/tevo-bw-pick-and-place/pnp/electronics/host_io_detail.png

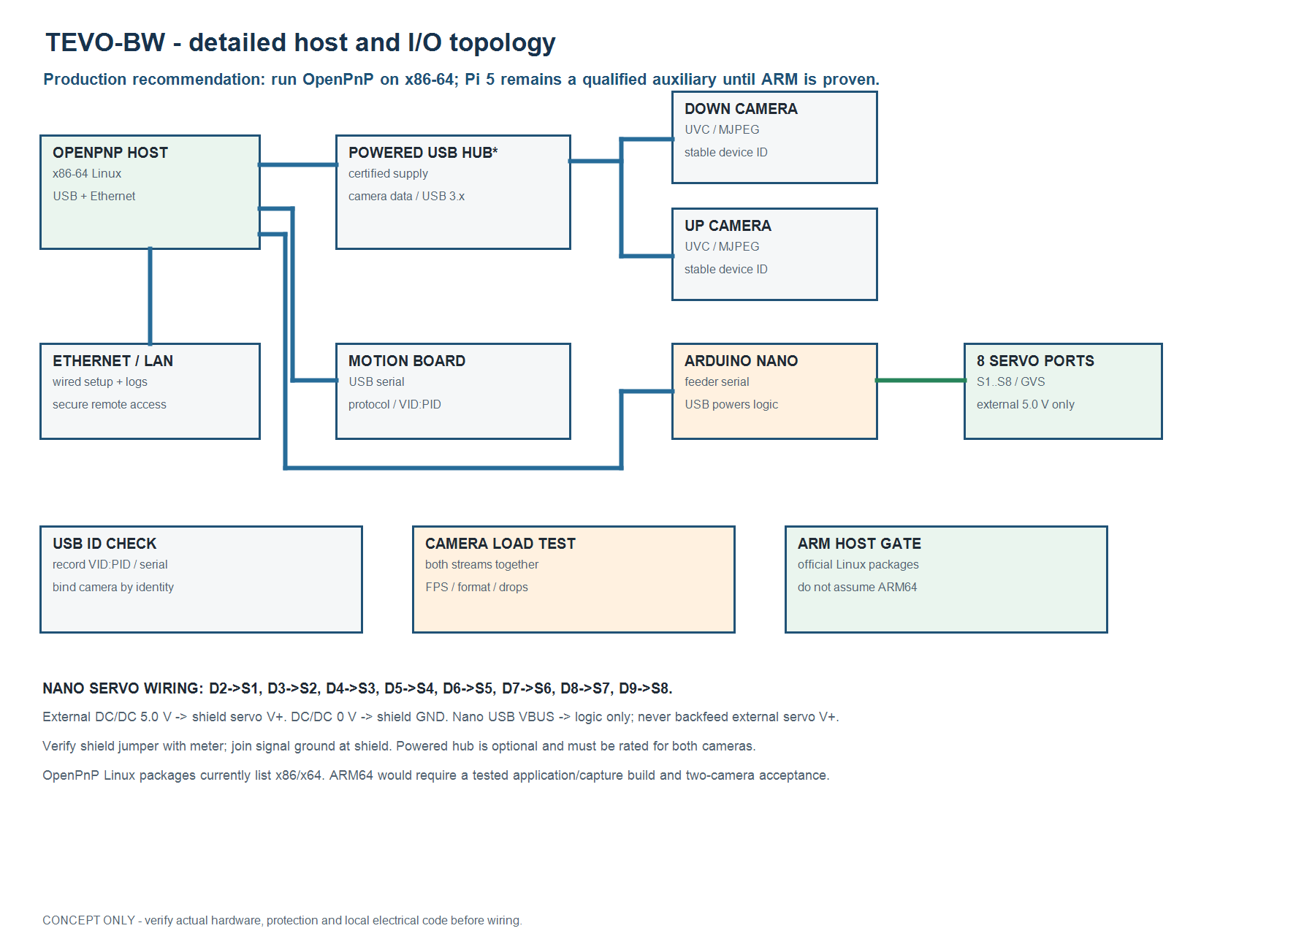
pnp/electronics/host_io_detail.png
