gionix38/tevo-bw-pick-and-place/pnp/feeder/out/feeder_animation.gif

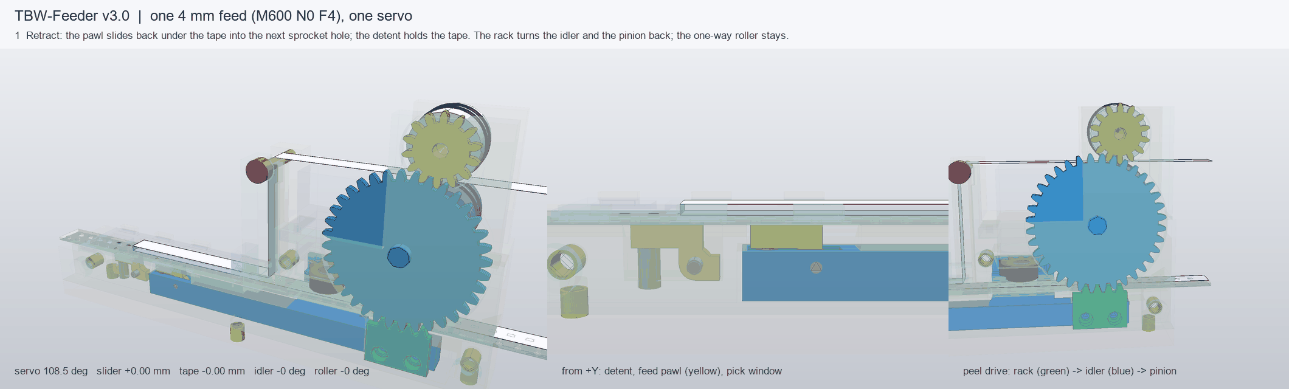
pnp/feeder/out/feeder_animation.gif
