gionix38/tevo-bw-pick-and-place/pnp/feeder/out/peel_exploded.png

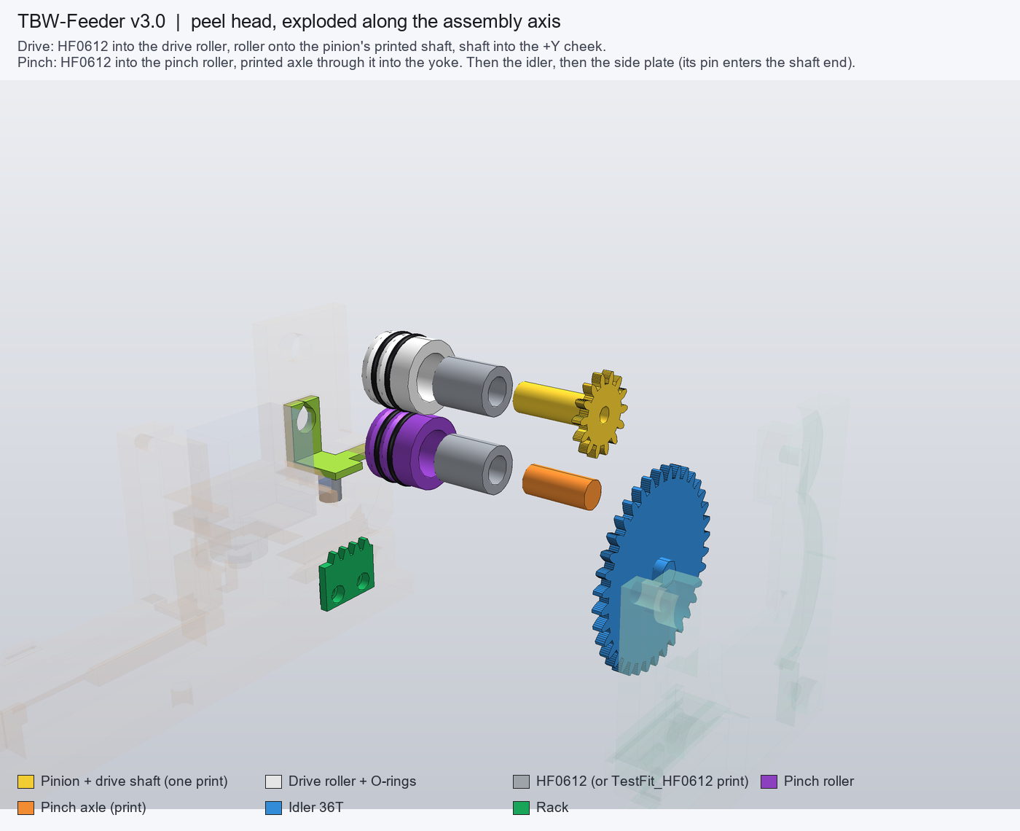
pnp/feeder/out/peel_exploded.png
