gionix38/tevo-bw-pick-and-place/pnp/out/render/camera.png

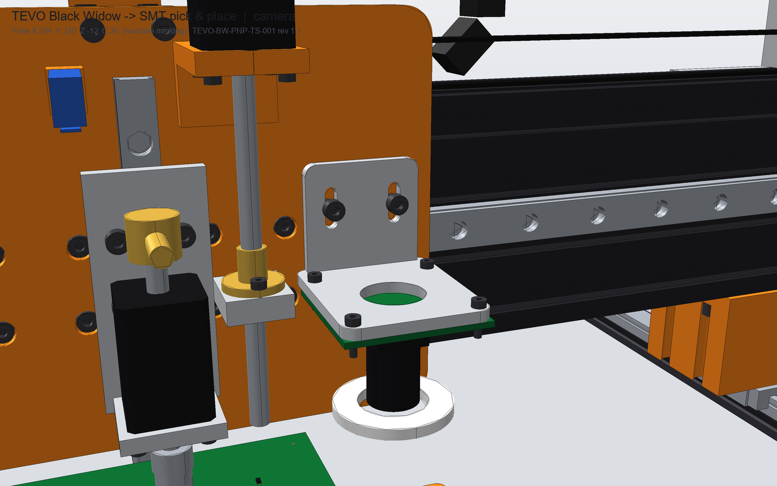
pnp/out/render/camera.png
