gionix38/tevo-bw-pick-and-place/pnp/out/render/details.png

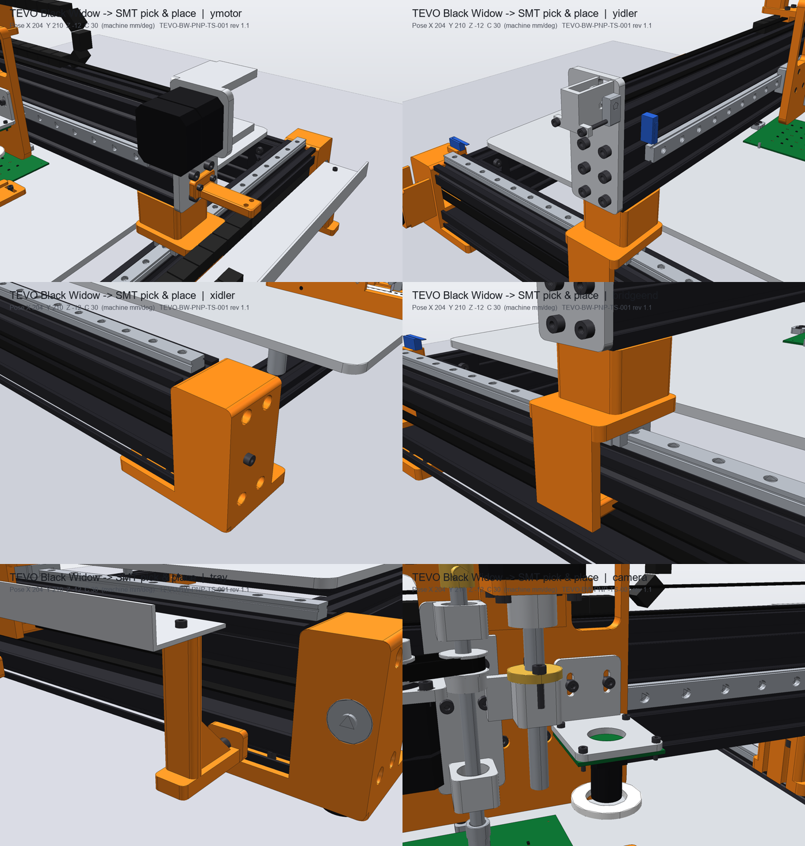
pnp/out/render/details.png
