gionix38/tevo-bw-pick-and-place/pnp/out/render/feeder.png

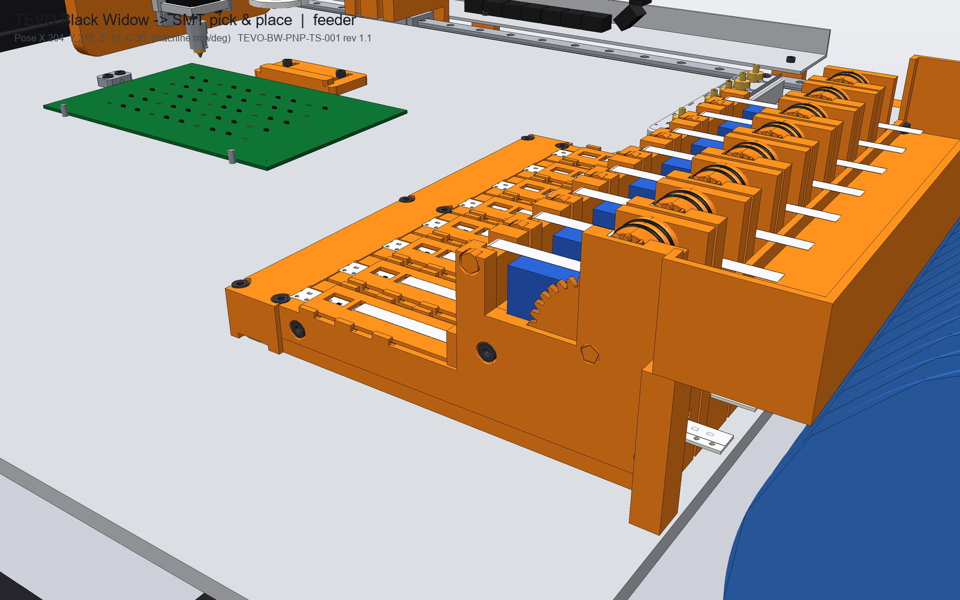
pnp/out/render/feeder.png
