gionix38/tevo-bw-pick-and-place/pnp/out/render/feeder_mech.png

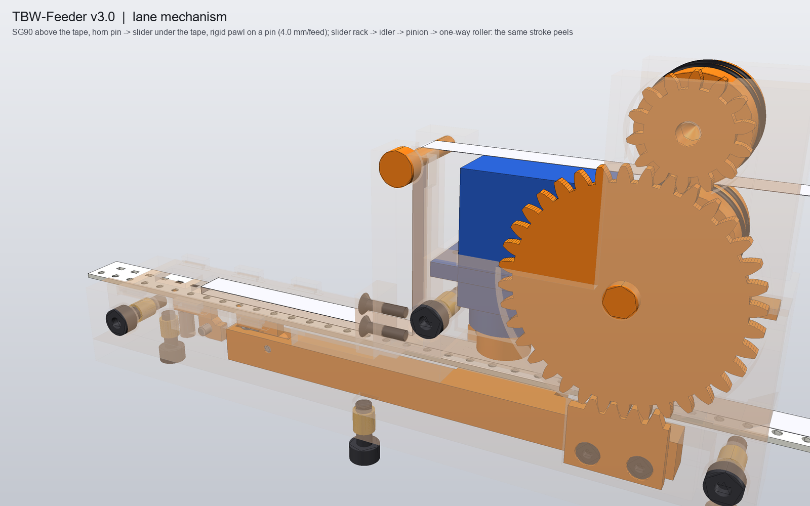
pnp/out/render/feeder_mech.png
