gionix38/tevo-bw-pick-and-place/pnp/out/render/feeder_sheet.png

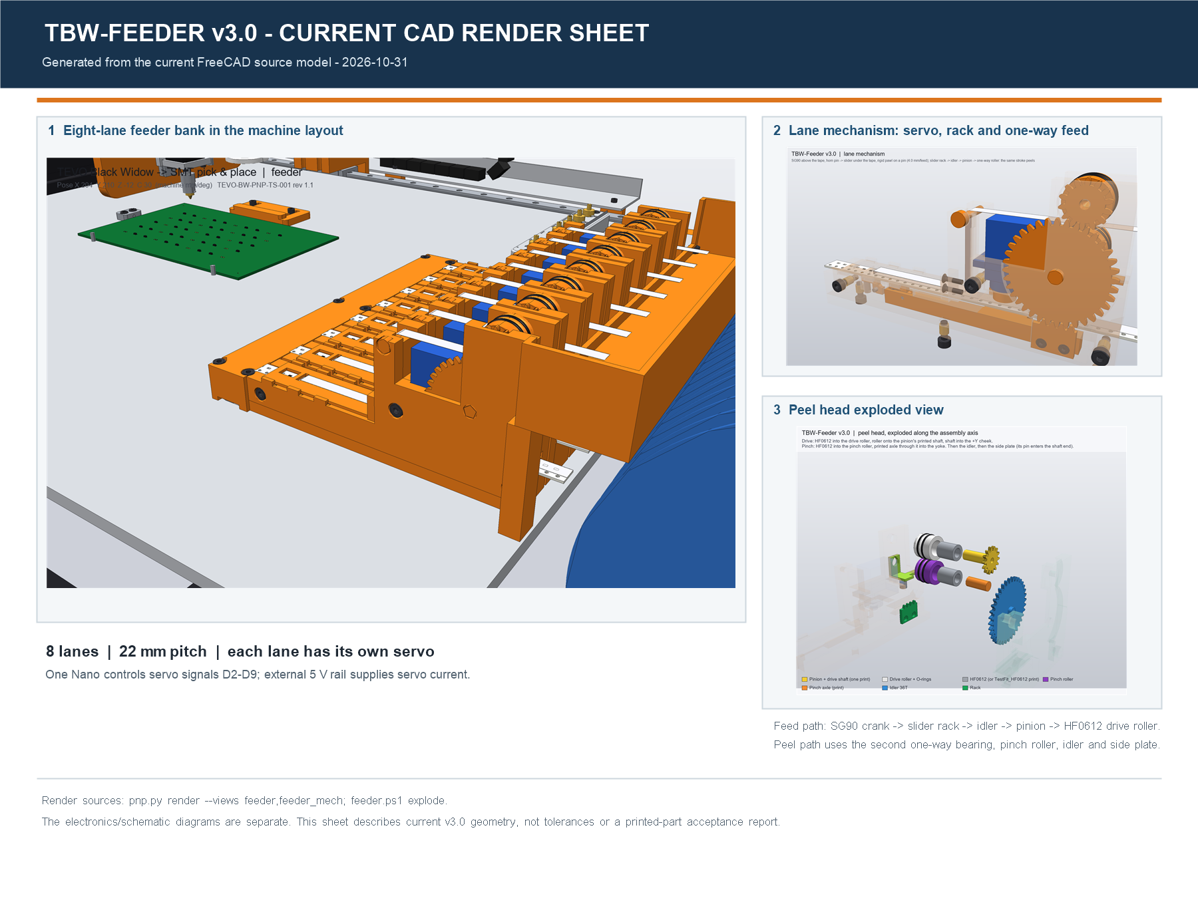
pnp/out/render/feeder_sheet.png
