gionix38/tevo-bw-pick-and-place/pnp/out/render/head.png

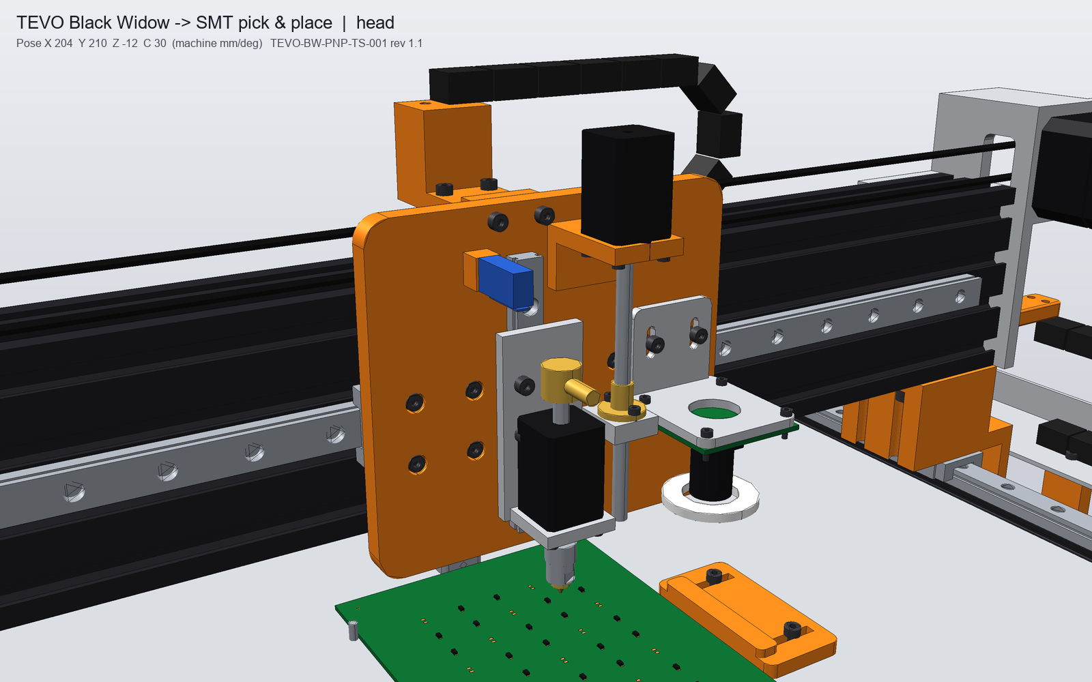
pnp/out/render/head.png
