gionix38/tevo-bw-pick-and-place/pnp/out/render/head_front.png

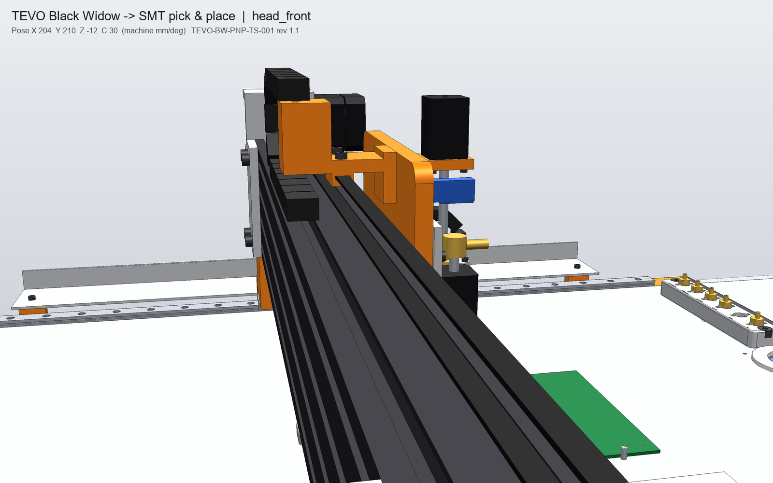
pnp/out/render/head_front.png
