gionix38/tevo-bw-pick-and-place/pnp/out/render/iso.png

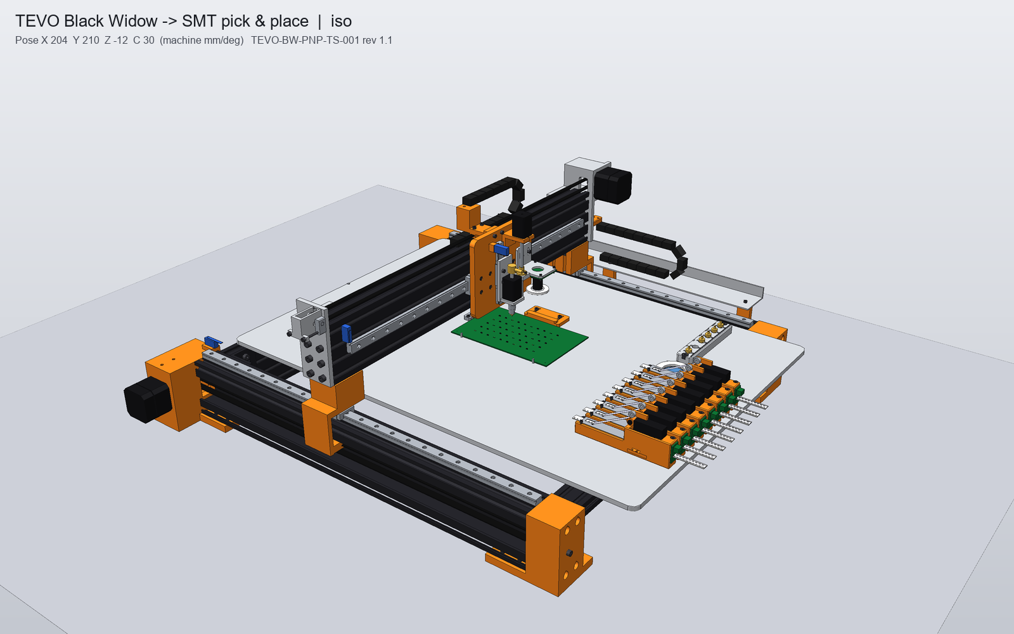
pnp/out/render/iso.png
