gionix38/tevo-bw-pick-and-place/pnp/out/render/iso_rear.png

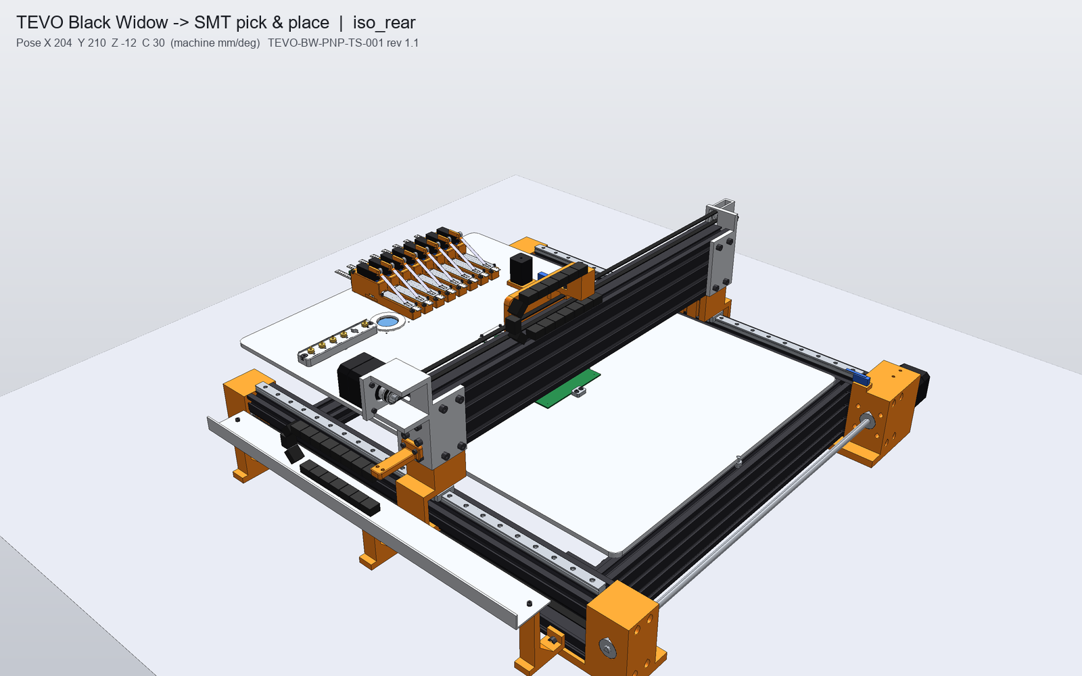
pnp/out/render/iso_rear.png
