gionix38/tevo-bw-pick-and-place/pnp/out/render/revD.png

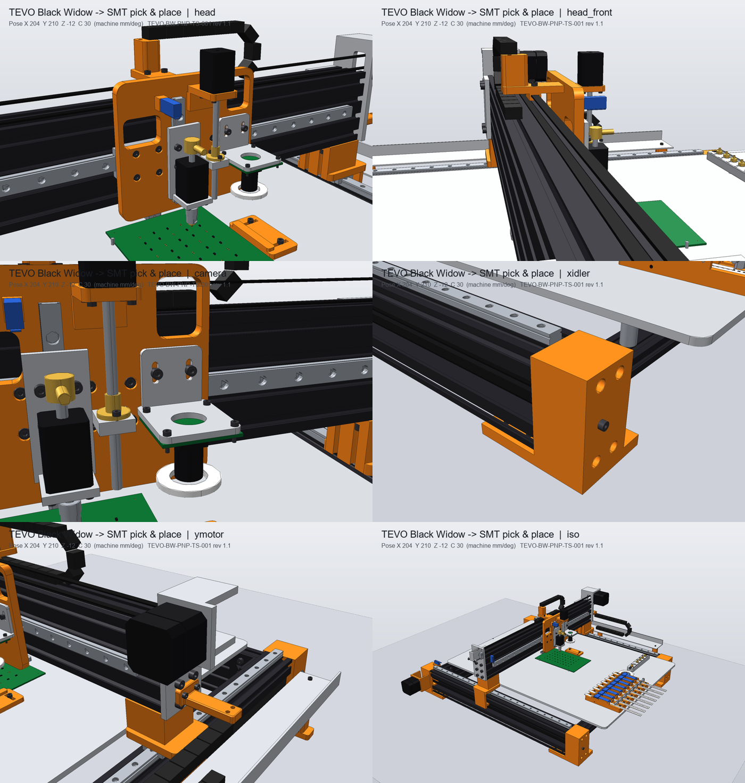
pnp/out/render/revD.png
