gionix38/tevo-bw-pick-and-place/pnp/out/render/side.png

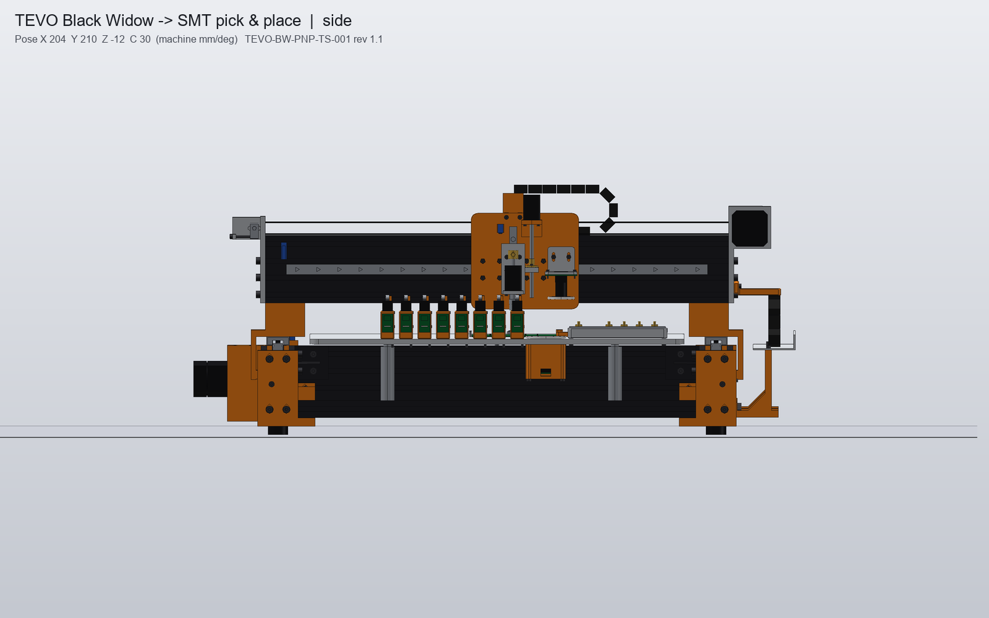
pnp/out/render/side.png
