gionix38/tevo-bw-pick-and-place/pnp/out/render/strip.png

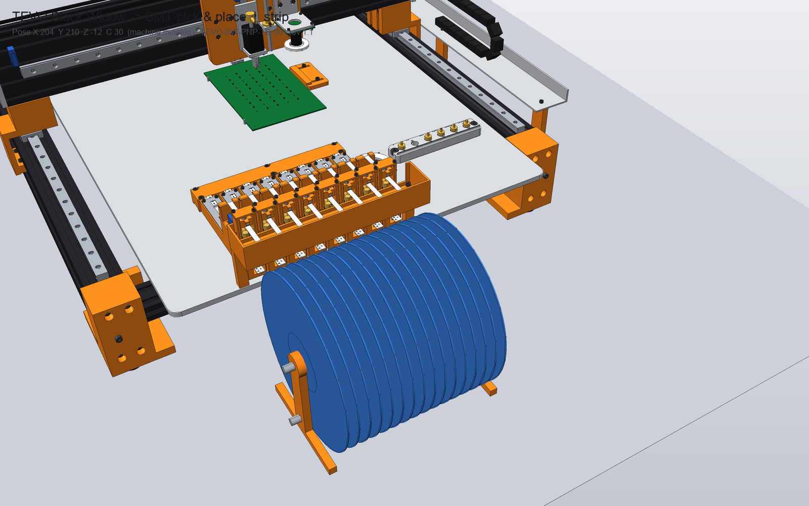
pnp/out/render/strip.png
