gionix38/tevo-bw-pick-and-place/pnp/out/render/table.png

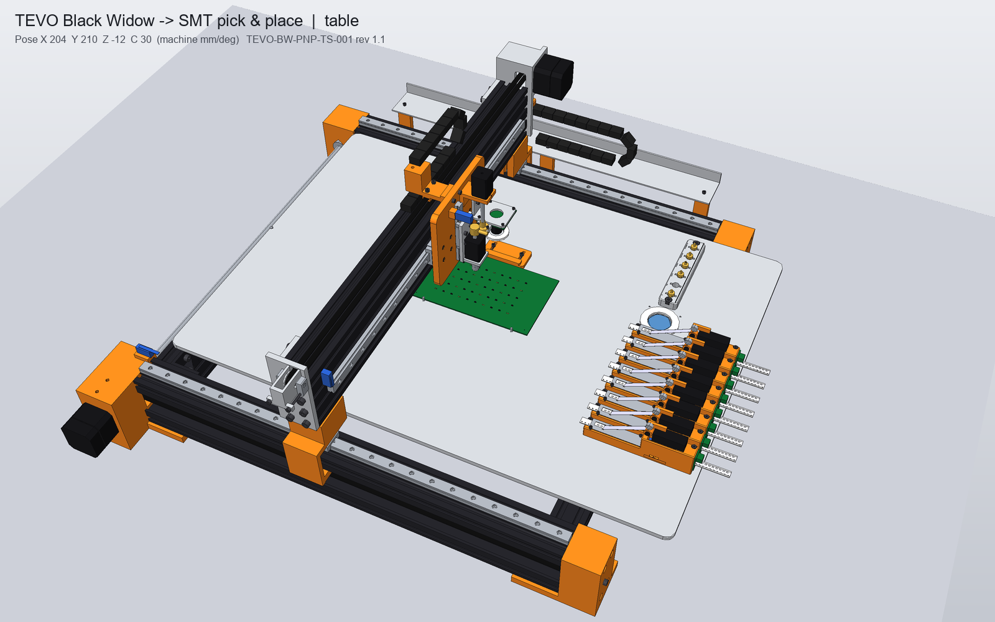
pnp/out/render/table.png
