gionix38/tevo-bw-pick-and-place/pnp/out/render/top.png

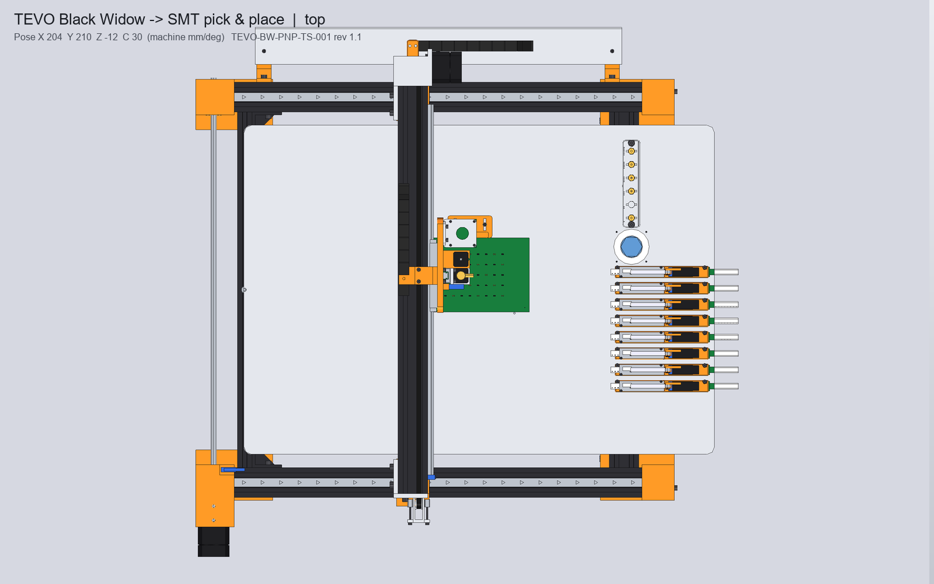
pnp/out/render/top.png
