gionix38/tevo-bw-pick-and-place/pnp/out/render/tray.png

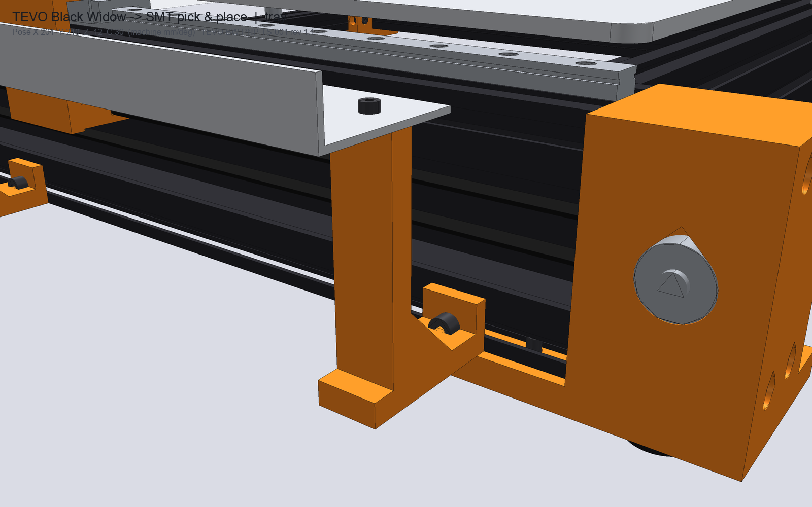
pnp/out/render/tray.png
