gionix38/tevo-bw-pick-and-place/pnp/out/render/xdrive.png

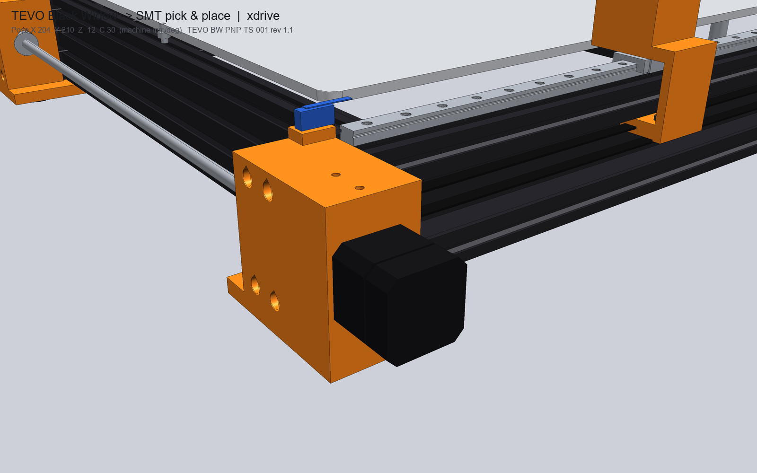
pnp/out/render/xdrive.png
