gionix38/tevo-bw-pick-and-place/pnp/out/render/xidler.png

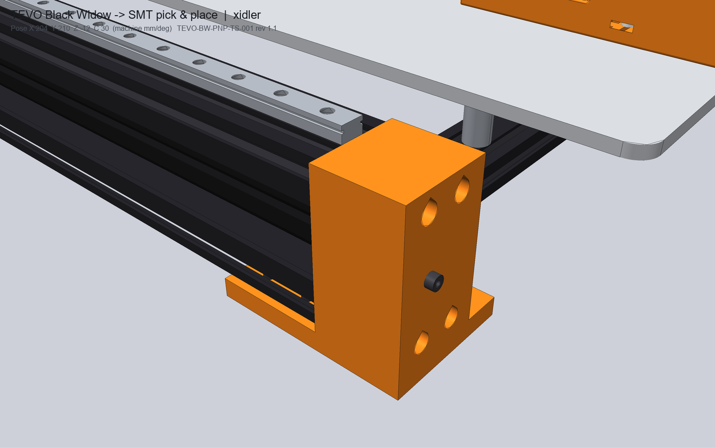
pnp/out/render/xidler.png
