gionix38/tevo-bw-pick-and-place/pnp/out/render/yidler.png

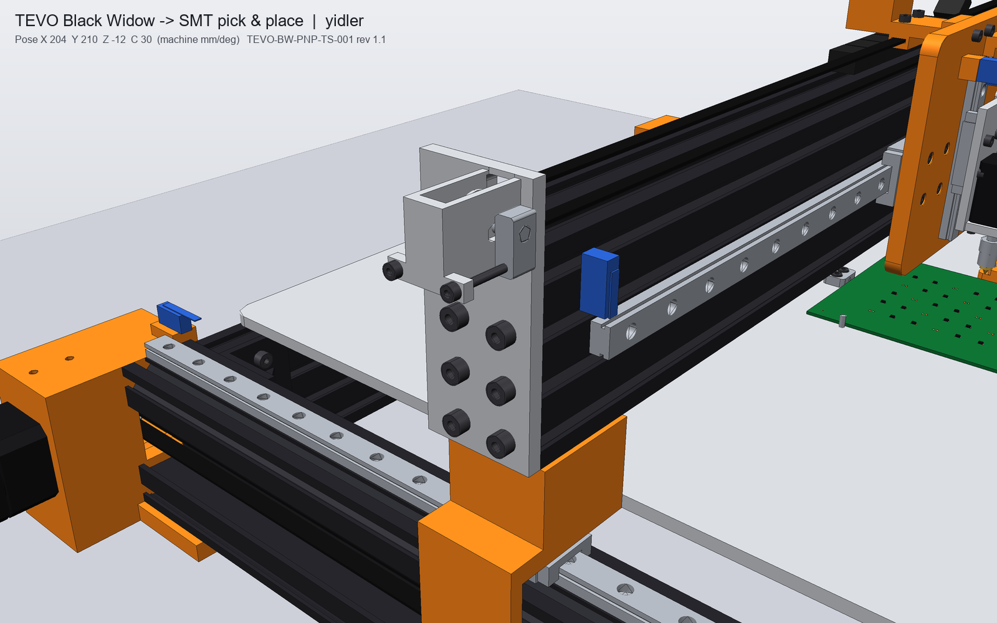
pnp/out/render/yidler.png
