gionix38/tevo-bw-pick-and-place/pnp/out/render/ymotor.png

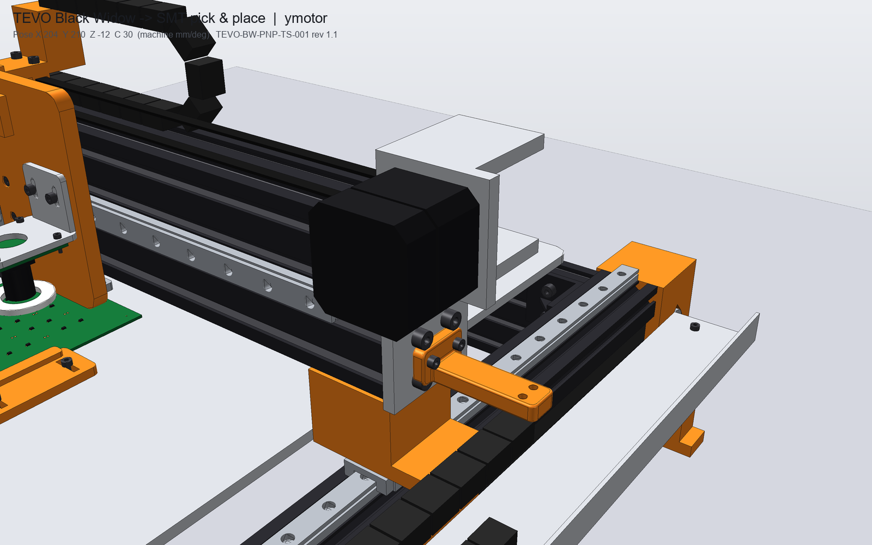
pnp/out/render/ymotor.png
