gionix38/tevo-bw-pick-and-place/pnp/out/bom.csv

kind | item | qty | systems | mass_g_total | note
stock | C-Beam 40x80x550 (stock Z column), laid horizontal | 2 | frame | 2640.0
stock | Drag chain 10x15 (stock), X run | 1 | chains | 0.0
stock | Drag chain 10x15 (stock), Y run | 1 | chains | 0.0
stock | Endstop microswitch (stock) | 2 | head/y_axis | 6.0
stock | Endstop microswitch with long lever (stock) | 1 | x_axis | 4.0
stock | NEMA17 (stock X motor) -> Y | 1 | y_axis | 280.0
stock | NEMA17 (stock bed motor) -> X | 1 | x_axis | 280.0
stock | V-slot 20x40x485 (stock X gantry bar) cut to 480, tie | 1 | frame | 384.0
stock | V-slot 20x80x500 (stock top tie) cut to 480, tie | 1 | frame | 720.0
stock | V-slot 40x80x550 (stock), Y bridge | 1 | y_axis | 1320.0
buy | Bearing 608ZZ 8x22x7 | 4 | x_axis | 48.0
buy | Camera board OV9281 global shutter 1280x800 mono, USB UVC, M12 mount, 38x38 mm (down + up) | 2 | head/table | 20.0
buy | Compliance spring + sleeve on the hollow shaft, ~1 N, 1.0-1.5 mm stroke | 1 | head | 2.7
buy | Compression spring OD 5 x 0.4 wire x L0 9, ~0.75 N/mm (pinch, 1.5 N) | 8 | feeders | 0.8
buy | Corner bracket 40x40 cast Al (tie -> C-beam) | 2 | frame | 80.0
buy | Coupler 5-8 mm | 1 | x_axis | 18.0
buy | Datum pin 3 mm hardened, press fit | 2 | table | 1.3
buy | Dowel pin ISO 8734 2 x 18 m6 (horn pin) | 8 | feeders | 3.2
buy | GT2 belt 9 mm, open, 1300 mm (ends clamped in the bridge end) | 2 | x_axis | 196.6
buy | GT2 idler 20T, 5 mm bore, 9 mm belt | 2 | x_axis | 7.4
buy | GT2 pulley 20T, 8 mm bore, 9 mm belt | 2 | x_axis | 10.6
buy | Idler axle M5x25 + nyloc | 2 | x_axis | 6.5
buy | Idler axle M5x30 + nyloc | 1 | y_axis | 4.6
buy | Jackshaft 8 mm ground rod, 592 mm | 1 | x_axis | 233.6
buy | Juki-compatible nozzle holder (CP40/500 pattern), 5 mm shaft bore | 1 | head | 3.3
buy | Juki-compatible tip (set of 6, see TS 7.4) | 1 | magazine | 1.5
buy | LED ring 12/24 V, diffuse (camera light) | 1 | head | 6.0
buy | LED ring diffuse (up camera silhouette light) | 1 | table | 8.0
buy | M12 lens f = 10 mm, for 1/4" sensor or larger, low distortion, with lock nut (down camera: FOV ~18.5 x 11.6 mm at the PCB, 0.014 mm/px) | 1 | head | 8.0
buy | M12 lens f = 6 mm, for 1/4" sensor or larger, low distortion, with lock nut (up camera: FOV ~21 x 13 mm at the hovering part, 0.017 mm/px) | 1 | table | 8.0
buy | MGN12 rail 500 mm | 1 | y_axis | 325.0
buy | MGN12 rail 550 mm | 2 | x_axis | 715.0
buy | MGN12H block | 4 | x_axis/y_axis | 148.0
buy | MGN9 rail 90 mm | 1 | head | 34.2
buy | MGN9H block | 1 | head | 26.0
buy | Magazine retaining leaf spring | 1 | magazine | 0.7
buy | NEMA8 external linear stepper 20x20x30, T5x2 screw 95 mm (head Z) | 1 | head | 60.0
buy | NEMA8 hollow-shaft stepper 20x20x30, shaft OD5/ID3, runout <= 0.02 mm (nozzle C) | 1 | head | 60.0
buy | Rotary vacuum swivel M5 for 5 mm shaft, 4 mm push-in | 1 | head | 10.0
buy | Servo SG90 9 g, 180 deg, analog (tape advance) | 8 | feeders | 72.0
buy | Spring plunger X stop block | 1 | table | 5.9
buy | Table support: M5 levelling screw + lock nut | 1 | table | 3.6
buy | Table support: M5 levelling screw + lock nut on Al post D16 | 2 | table | 208.1
buy | Threaded rod M8 x 212 + 2 nuts + 2 washers (reel rack) | 2 | feeders | 167.5
buy | Up camera cover glass D29 | 1 | table | 1.0
make | Down camera angle, Al 3 mm, slotted for focus | 1 | head | 18.8
make | Nozzle magazine bar, Al 24x12, 6 pockets along Y | 1 | magazine | 78.9
make | Tooling plate Al 6 mm 635 x 444, PCB area + tooling strip (one piece) | 1 | table | 4504.5
make | X chain tray, Al angle 50x18x2, 495 mm | 1 | chains | 176.3
make | Y idler bracket, machined Al (end plate + side flange + slotted cheeks) | 1 | y_axis | 140.3
make | Y motor bracket, machined Al 6 mm (end plate + motor plate + side flange + gussets) | 1 | y_axis | 224.6
make | Y tension block, steel 7x10x12, M3 tapped | 2 | y_axis | 17.6
make | Z slide, one piece: block plate + C motor arm + nut seat (CNC Al 6061) | 1 | head | 25.1
print | Bridge end: foot + riser + belt clamp (printed PETG-CF, 100% infill) | 2 | x_axis | 172.9
print | Cheek cap, snap-on, with lifter stop (printed PETG) | 8 | feeders | 4.2
print | Corner block front-left with X motor mount (printed PETG/ASA) | 1 | frame | 325.2
print | Corner block front-right (printed PETG/ASA) | 1 | frame | 178.6
print | Corner block rear-left (printed PETG/ASA) | 1 | frame | 198.9
print | Corner block rear-right (printed PETG/ASA) | 1 | frame | 178.6
print | Cover tape waste bin (printed PETG) | 1 | feeders | 27.5
print | Drive roller D14 x 6, D-bore (printed TPU 95A) | 8 | feeders | 5.2
print | Empty-tape exit chute, 8 lanes (printed PETG) | 1 | feeders | 48.2
print | Feeder v2.1 cover plate 1.2 mm with detent tongue (printed PETG, upside down) | 8 | feeders | 8.8
print | Feeder v2.1 hold pawl (printed PETG) | 8 | feeders | 0.9
print | Feeder v2.1 lane body (printed PETG) | 8 | feeders | 386.4
print | Feeder v2.1 peel lifter with flexure pawl (printed PETG) | 8 | feeders | 4.5
print | Feeder v2.1 ratchet 18T + hub (printed PETG) | 8 | feeders | 3.7
print | Feeder v2.1 slider with flexure pawl (printed PETG) | 8 | feeders | 21.9
print | Head belt clamp + Y chain post (printed PETG-CF) | 1 | head | 21.7
print | Head carriage plate: block mount + Z rail + Z motor shelf (printed PETG-CF) | 1 | head | 106.6
print | PCB slide clamp (printed PETG) | 1 | table | 8.5
print | Pinch axle D3 x 10 (printed PETG, lying) | 8 | feeders | 0.5
print | Pinch roller D7 x 3, runs on its axle (printed PETG) | 8 | feeders | 0.6
print | Pinch yoke (printed PETG) | 8 | feeders | 3.8
print | Reel hub / spacer (printed PETG) | 8 | feeders | 28.3
print | Reel rack side plate (printed PETG) | 2 | feeders | 40.2
print | Roller axle D3 x 20, stationary (printed PETG, lying) | 8 | feeders | 1.0
print | Slider peg D3 x 8 (printed PETG, lying) | 8 | feeders | 0.4
print | Up camera housing, one piece (printed PETG) | 1 | table | 24.6
print | Waste bin leg (printed PETG) | 2 | feeders | 5.8
print | X chain arm (printed PETG), on the Y motor bracket | 1 | chains | 7.8
print | X chain tray bracket (printed PETG) | 3 | chains | 66.5
print | X idler tension slider (printed PETG) | 2 | x_axis | 10.0
fastener | Grub screw M4 (pulley) | 4 | x_axis | 0.0
fastener | M2 heat-set insert | 32 | feeders | 0.0
fastener | M2x10 screw (X home switch) | 2 | frame | 0.0
fastener | M2x10 screw (microswitch) | 2 | head | 0.0
fastener | M2x10 screw + M3 T-nut adapter (microswitch) | 2 | y_axis | 0.0
fastener | M2x5 screw (leaf spring) | 2 | magazine | 0.0
fastener | M2x6 SHCS (NEMA8 hollow, from below) | 4 | head | 0.0
fastener | M2x6 SHCS (servo tabs) | 16 | feeders | 0.0
fastener | M2x6 knurled thumb screw (cover plate) | 16 | feeders | 0.0
fastener | M2x6 screw (camera board) | 4 | table | 0.0
fastener | M2x8 SHCS (NEMA8) | 4 | head | 0.0
fastener | M2x8 SHCS + nut (flange nut) | 2 | head | 0.0
fastener | M2x8 screw + 3 mm spacer (camera board) | 4 | head | 0.0
fastener | M3 heat-set insert | 2 | head | 0.0
fastener | M3 heat-set insert (lane bottom) | 24 | feeders | 0.0
fastener | M3x10 SHCS (NEMA) | 4 | y_axis | 0.0
fastener | M3x10 SHCS (NEMA, from the inner face, 2.5 mm ball-end key 100 mm) | 4 | frame | 0.0
fastener | M3x10 SHCS (into bracket, tapped) | 2 | chains | 0.0
fastener | M3x10 SHCS + washer (clamp slots) | 2 | table | 0.0
fastener | M3x12 SHCS (MGN block) | 8 | x_axis | 0.0
fastener | M3x12 SHCS (tooling plate -> lane, from below) | 24 | feeders | 0.0
fastener | M3x12 SHCS + nut (belt clamp) | 4 | x_axis | 0.0
fastener | M3x14 SHCS (plate -> belt clamp insert) | 2 | head | 0.0
fastener | M3x20 SHCS (chute -> plate) | 6 | feeders | 0.0
fastener | M3x30 SHCS (Y belt tension) | 2 | y_axis | 0.0
fastener | M3x45 SHCS (housing -> plate) | 4 | table | 0.0
fastener | M3x55 SHCS + washer (bin + leg -> plate) | 2 | feeders | 0.0
fastener | M3x6 low-head screw (MGN9H block) | 4 | head | 0.0
fastener | M3x6 set screw + heat-set insert (belt clamp, presses belt end) | 2 | head | 0.0
fastener | M3x8 SHCS | 2 | table | 0.0
fastener | M3x8 SHCS (MGN block) | 8 | head | 0.0
fastener | M3x8 SHCS + M3 T-nut (MGN rail) | 64 | x_axis/y_axis | 0.0
fastener | M3x8 SHCS + heat-set insert (MGN9 rail) | 4 | head | 0.0
fastener | M3x8 SHCS + heat-set insert (chain end) | 4 | chains/head | 0.0
fastener | M3x8 SHCS + heat-set insert (tray) | 3 | chains | 0.0
fastener | M3x8 SHCS + washer + heat-set insert (camera angle) | 2 | head | 0.0
fastener | M4 nut (in slider trap) | 2 | x_axis | 0.0
fastener | M4x20 SHCS + nut (idler tension) | 2 | frame | 0.0
fastener | M5x10 SHCS + M5 T-nut | 42 | frame | 0.0
fastener | M5x10 SHCS + M5 T-nut (C-beam lower slot) | 3 | chains | 0.0
fastener | M5x10 SHCS + M5 T-nut (bridge beam) | 8 | x_axis | 0.0
fastener | M5x12 SHCS (tie end tap -> C-beam slot) | 6 | frame | 0.0
fastener | M5x12 SHCS + M5 T-nut (beam side slot) | 8 | y_axis | 0.0
fastener | M5x12 SHCS + T-nut (support base) | 3 | table | 0.0
fastener | M5x16 SHCS (beam end tap) | 12 | y_axis | 0.0
fastener | M5x16 SHCS (magazine -> plate) | 2 | magazine | 0.0
fastener | M5x45 SHCS (corner block -> C-beam end tap) | 16 | frame | 0.0
fastener | Rubber foot M6 stud, D24x10 | 4 | frame | 0.0
fastener | Shaft collar 8 mm | 2 | x_axis | 0.0
