gionix38/tevo-bw-pick-and-place/pnp/feeder/out/stl/CoverPlate.stl

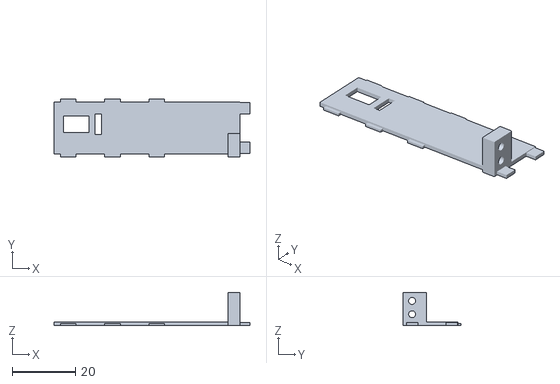
[picture p26: CAD file, 2026-11-01]
pnp/feeder/out/stl/CoverPlate.stl
62.0 x 18.5 x 10.5
