gionix38/tevo-bw-pick-and-place/pnp/feeder/out/tbw_feeder_lane.step

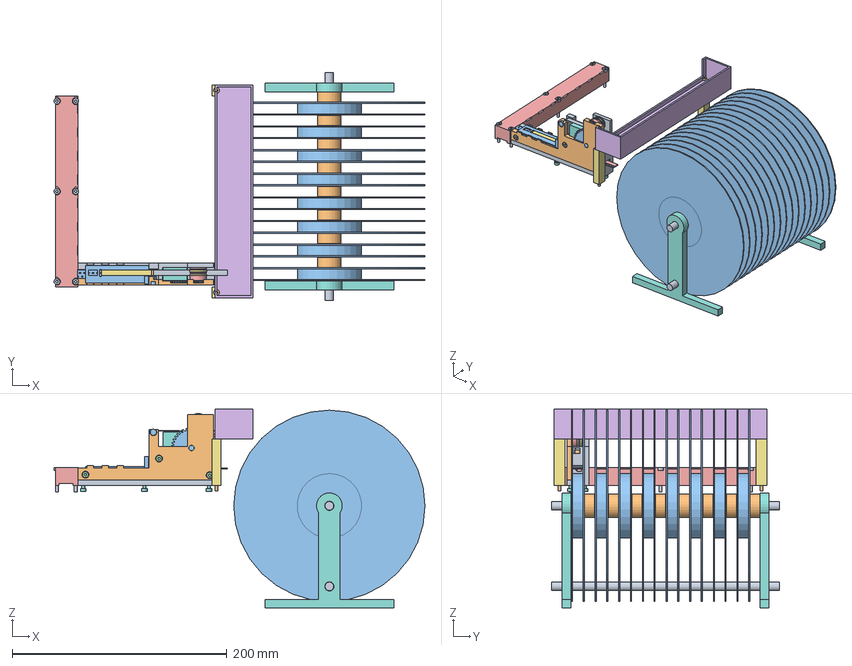
[picture p27: CAD file, 2026-11-01]
pnp/feeder/out/tbw_feeder_lane.step
345.2 x 212.3 x 185.0 mm
SidePlate
CoverPlate
Slider
Pawl_1
Pawl_2
PawlPin_1
PawlSpring_1
PawlPin_2
PawlSpring_2
Servo_SG90
ServoGear
Rack
Idler
Pinion
DriveRoller
OneWay_1
OneWay_2
ORing_1
ORing_2
ORing_3
ORing_4
PinchRoller
PinchAxle
PinchYoke
PinchSpring
GuideBar
Inserts
CoverTape
Tape
TapeParts
Feeder_ExitChute
Feeder_WasteBin
Feeder_WasteBinLeg_1
Feeder_WasteBinLeg_2
ReelRack_Side_1
ReelRack_Side_2
ReelRack_Rod_1
ReelRack_Rod_2
ReelHub_1
Reel_1
ReelHub_2
Reel_2
ReelHub_3
Reel_3
ReelHub_4
Reel_4
ReelHub_5
Reel_5
ReelHub_6
Reel_6
ReelHub_7
Reel_7
ReelHub_8
Reel_8
Screws_Lane
Screws_Bank
