gionix38/tevo-bw-pick-and-place/pnp/out/parts_step/Nozzle_Magazine_Bar.step

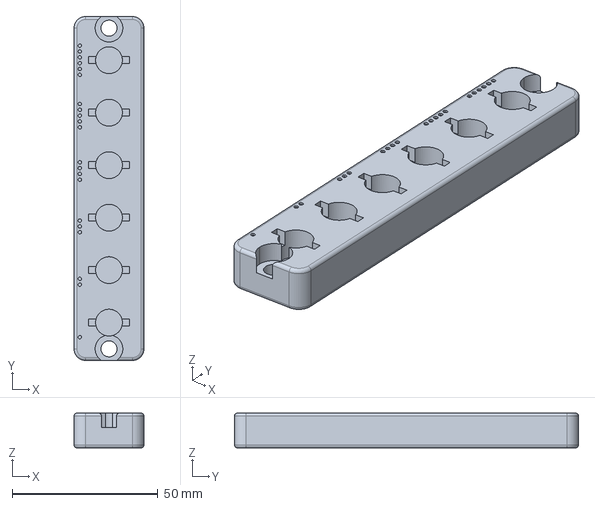
[picture p28: CAD file, 2026-11-01]
pnp/out/parts_step/Nozzle_Magazine_Bar.step
24.0 x 118.0 x 12.0 mm
