gionix38/tevo-bw-pick-and-place/pnp/out/parts_stl/XChain_TrayBracket_3.stl

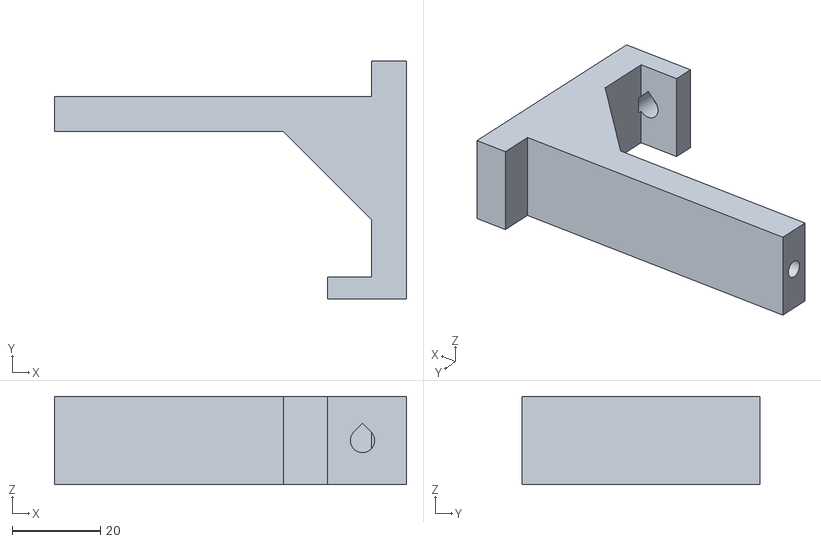
[picture p29: CAD file, 2026-11-01]
pnp/out/parts_stl/XChain_TrayBracket_3.stl
80.0 x 54.0 x 20.0
