gionix38/tevo-bw-pick-and-place/pnp/out/TEVO_BW_PnP_machine_parts.3mf

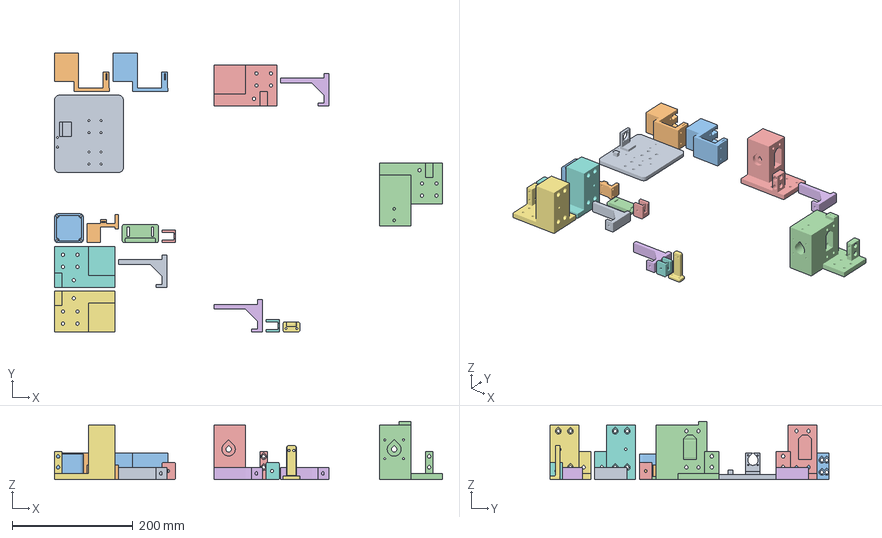
[picture p30: CAD file, 2026-11-01]
pnp/out/TEVO_BW_PnP_machine_parts.3mf
641.8 x 462.0 x 96.0 mm
Head_Carriage
Bridge_End_Front 1
Bridge_End_Front 2
Corner_FrontLeft
Corner_RearLeft
XChain_TrayBracket_1 x 3
Corner_FrontRight
Corner_RearRight
Head_BeltClamp
UpCam_Housing
PCB_SlideClamp
XIdler_Slider_Front x 2
XChain_Arm
