gionix38/tevo-bw-pick-and-place/pnp/feeder/out/stl/PinchAxle.stl

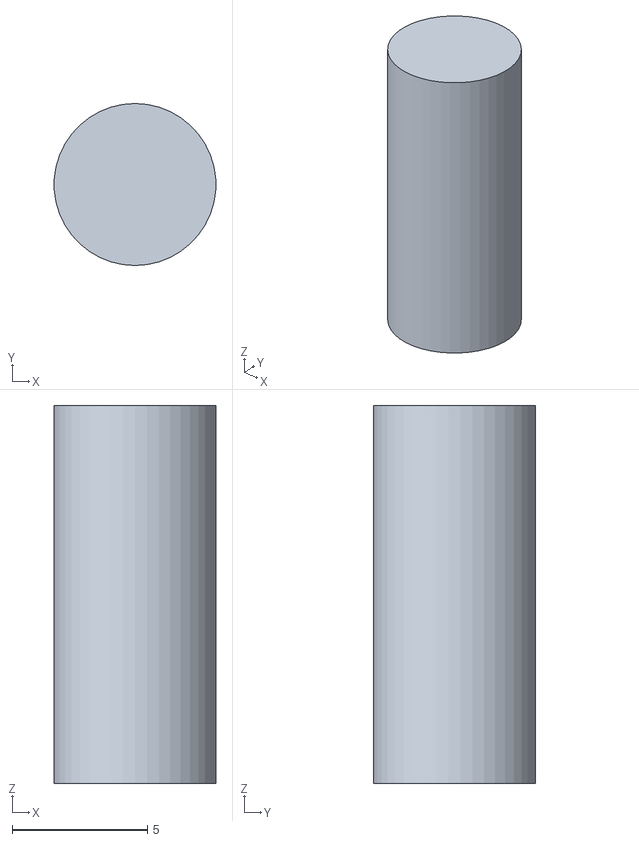
[picture p31: CAD file, 2026-11-01]
pnp/feeder/out/stl/PinchAxle.stl
5.98 x 6.00 x 14.0
