gionix38/tevo-bw-pick-and-place/pnp/feeder/out/TBW_Feeder_v3.0.3mf

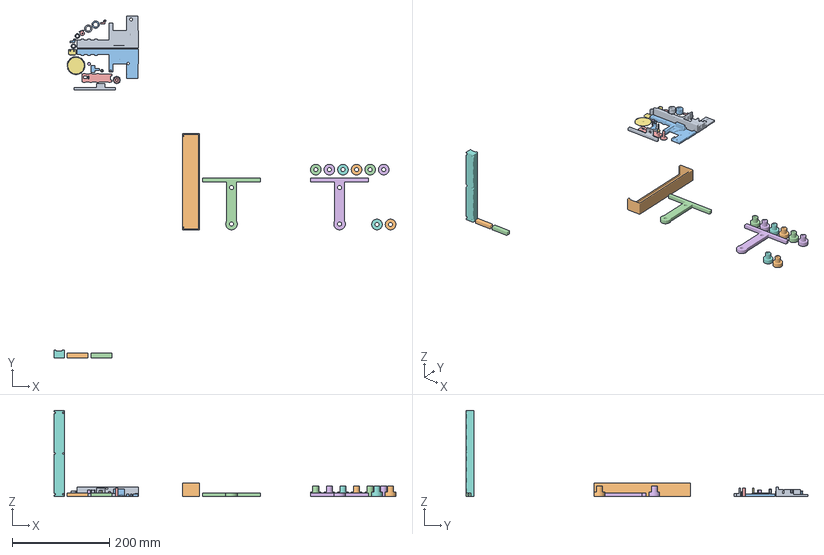
[picture p32: CAD file, 2026-11-01]
pnp/feeder/out/TBW_Feeder_v3.0.3mf
704.0 x 704.4 x 178.0 mm
Feeder_WasteBin
SidePlate
ReelRack_Side x 2
CoverPlate
Idler
ReelHub 1
Slider
ReelHub 2
PinchYoke
ReelHub 3
Pinion
ReelHub 4
Rack
ReelHub 5
DriveRoller 1
ReelHub 6
DriveRoller 2
ReelHub 7
ServoGear
ReelHub 8
TestFit_HF0612 1
Feeder_ExitChute
TestFit_HF0612 2
Feeder_WasteBinLeg 1
Pawl 1
Feeder_WasteBinLeg 2
Pawl 2
PinchAxle
GuideBar
