gionix38/tevo-bw-pick-and-place/pnp/out/parts_step/Tooling_Plate.step

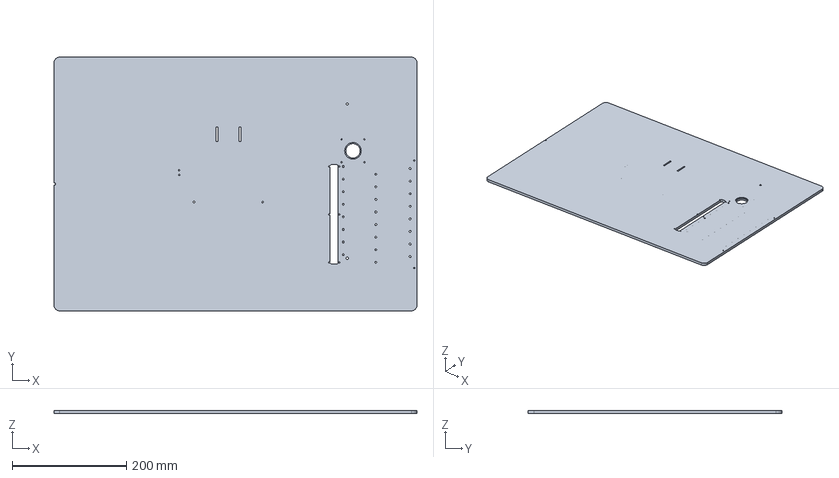
[picture p33: CAD file, 2026-11-01]
pnp/out/parts_step/Tooling_Plate.step
635.0 x 444.0 x 6.00 mm
