gionix38/tevo-bw-pick-and-place/pnp/out/parts_stl/Lane1_PinchRoller.stl

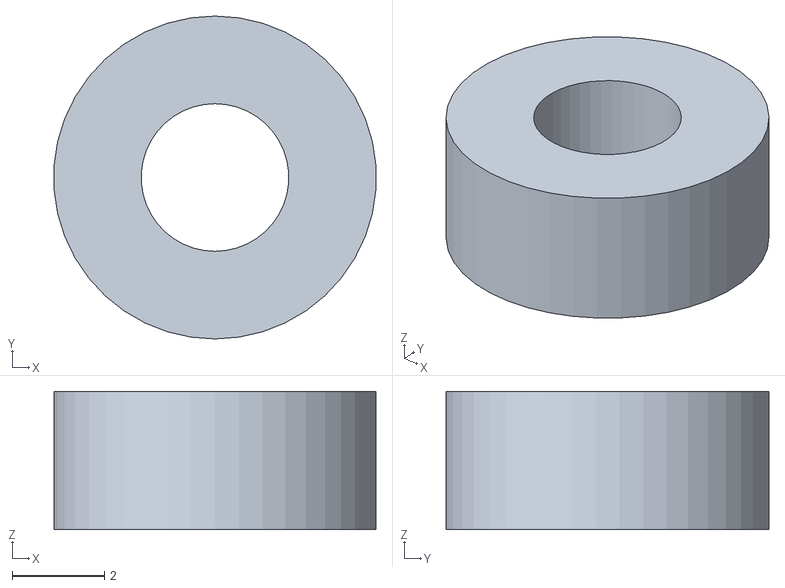
[picture p34: CAD file, 2026-11-01]
pnp/out/parts_stl/Lane1_PinchRoller.stl
6.98 x 7.00 x 3.00
