gionix38/tevo-bw-pick-and-place/pnp/out/pnp_machine.step

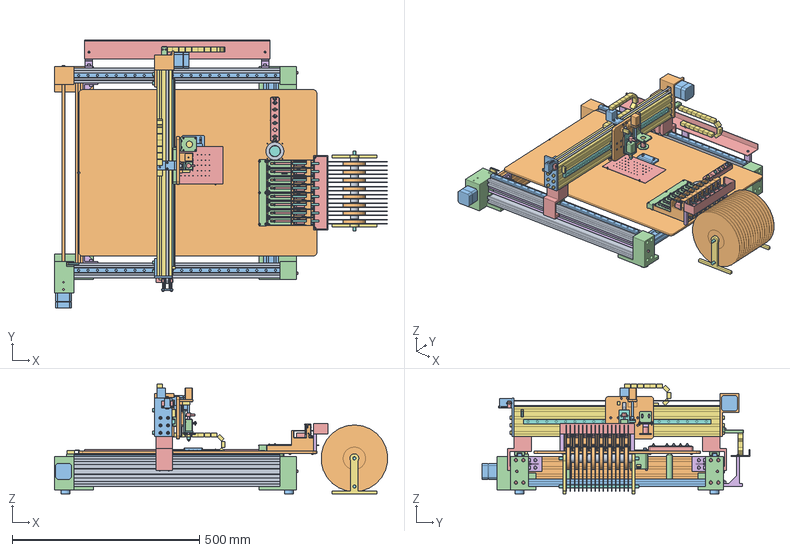
[picture p35: CAD file, 2026-11-01]
pnp/out/pnp_machine.step
888.4 x 714.0 x 293.0 mm
CBeam_Front
CBeam_Rear
Tie_Left_20x80
Tie_Right_20x40
Corner_FrontLeft
Screws_CornerFrontLeft
Corner_RearLeft
Screws_CornerRearLeft
Foot_FrontLeft
Foot_RearLeft
Corner_FrontRight
Screws_CornerFrontRight
Corner_RearRight
Screws_CornerRearRight
Foot_FrontRight
Foot_RearRight
TieBracket_Front
Screws_TieBracketFront
TieBracket_Rear
Screws_TieBracketRear
XHome_Switch
XIdler_Slider_Front
XIdler_Slider_Rear
Bearing608_FO
Bearing608_FI
Bearing608_RI
Bearing608_RO
XRail_Front
XBlock_Front
Bridge_End_Front
Screws_BridgeEndFront
XPulley_Front
XIdler_Front
XIdlerAxle_Front
XRail_Rear
XBlock_Rear
Bridge_End_Rear
Screws_BridgeEndRear
XPulley_Rear
XIdler_Rear
XIdlerAxle_Rear
XJackshaft
XMotor_NEMA17
XMotor_Shaft
XCoupler_5x8
XBelt_Front
XBelt_Rear
Bridge_Beam_40x80x550
YRail
YBlock_A
YBlock_B
YMotor_NEMA17
YMotor_Shaft
YPulley
YMotor_Bracket
Screws_YMotorBracket
YIdler_Bracket
Screws_YIdlerBracket
YTension_Block_1
YTension_Block_2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
