gionix38/tevo-bw-pick-and-place/pnp/feeder/out/stl/TestFit_HF0612.stl

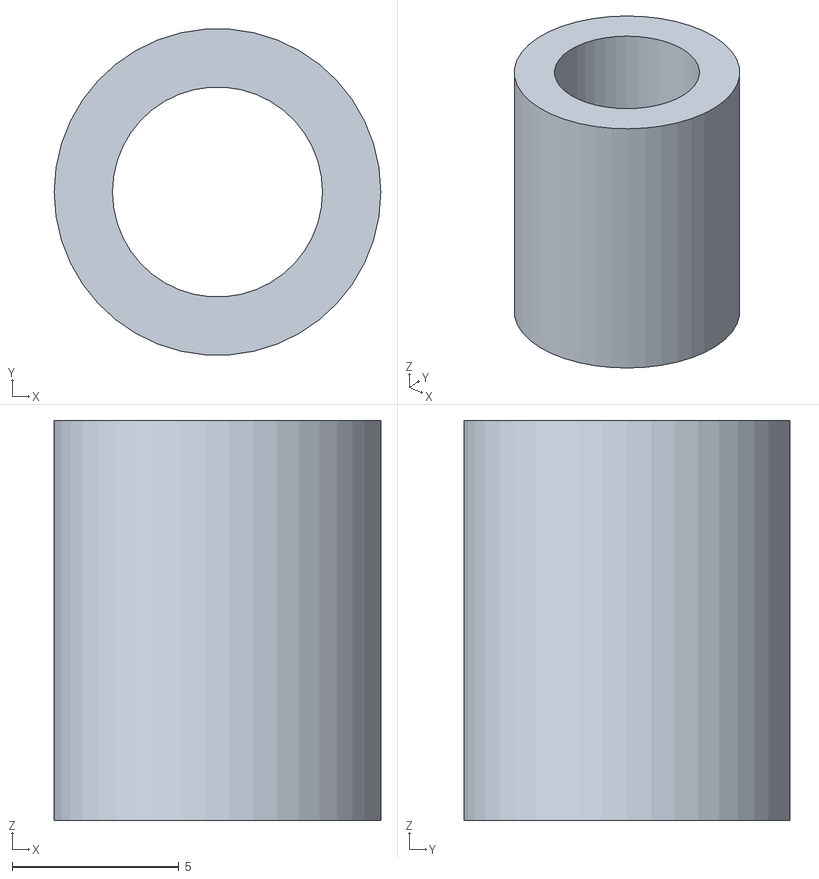
[picture p36: CAD file, 2026-11-01]
pnp/feeder/out/stl/TestFit_HF0612.stl
9.80 x 9.77 x 12.0
