gionix38/tevo-bw-pick-and-place/pnp/out/parts_step/YIdler_Bracket.step

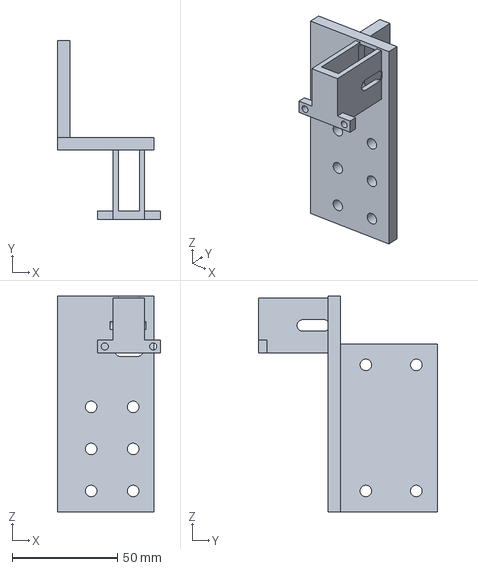
[picture p37: CAD file, 2026-11-01]
pnp/out/parts_step/YIdler_Bracket.step
49.0 x 85.0 x 102.8 mm
