gionix38/tevo-bw-pick-and-place/pnp/out/parts_stl/UpCam_Housing.stl

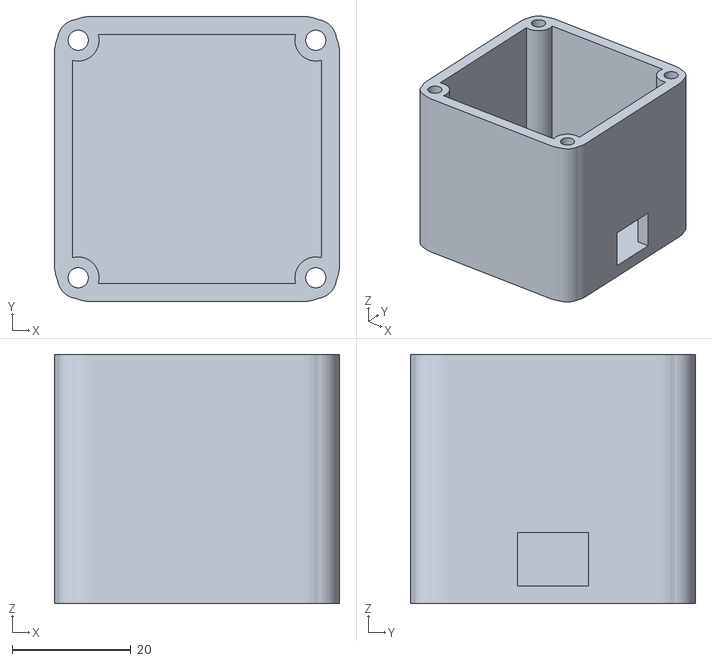
[picture p38: CAD file, 2026-11-01]
pnp/out/parts_stl/UpCam_Housing.stl
48.0 x 48.0 x 42.0
