gionix38/tevo-bw-pick-and-place/pnp/feeder/out/stl/ReelRack_Side.stl

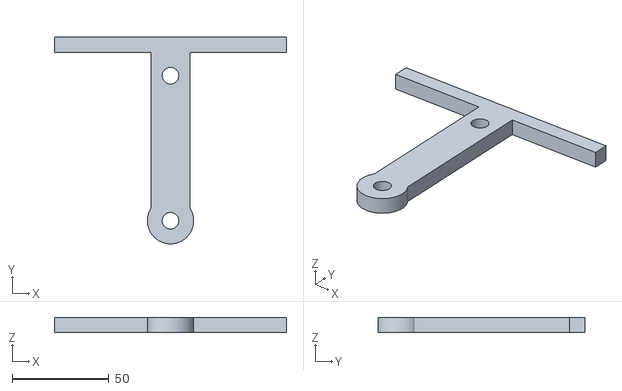
[picture p39: CAD file, 2026-11-01]
pnp/feeder/out/stl/ReelRack_Side.stl
120.0 x 107.0 x 8.00
