gionix38/tevo-bw-pick-and-place/pnp/out/parts_step/XChain_Tray.step

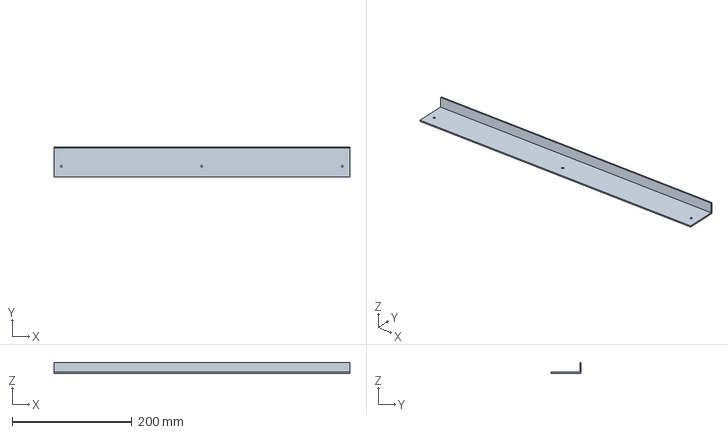
[picture p40: CAD file, 2026-11-01]
pnp/out/parts_step/XChain_Tray.step
495.0 x 50.0 x 18.0 mm
