gionix38/tevo-bw-pick-and-place/pnp/out/parts_stl/Lane1_CheekCap.stl

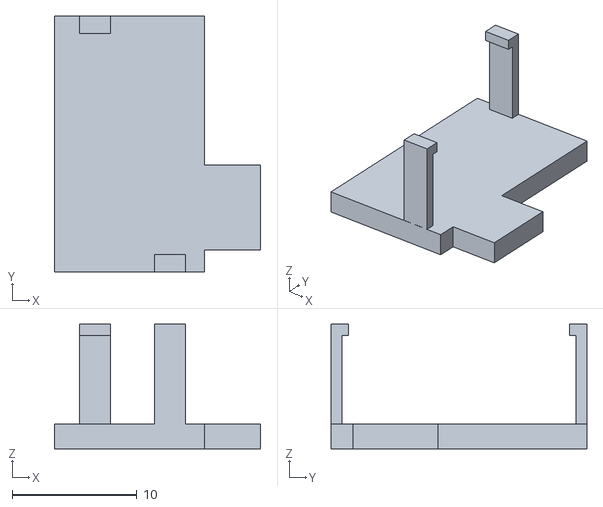
[picture p41: CAD file, 2026-11-01]
pnp/out/parts_stl/Lane1_CheekCap.stl
16.5 x 20.5 x 10.0
