gionix38/tevo-bw-pick-and-place/pnp/feeder/out/stl/PinchYoke.stl

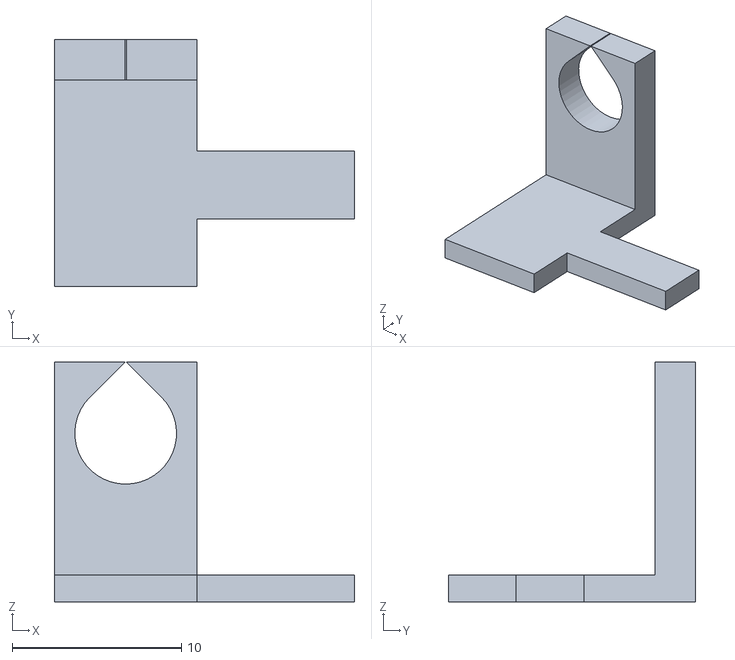
[picture p42: CAD file, 2026-11-01]
pnp/feeder/out/stl/PinchYoke.stl
17.7 x 14.6 x 14.1
