gionix38/tevo-bw-pick-and-place/pnp/out/parts_step/YTension_Block_1.step

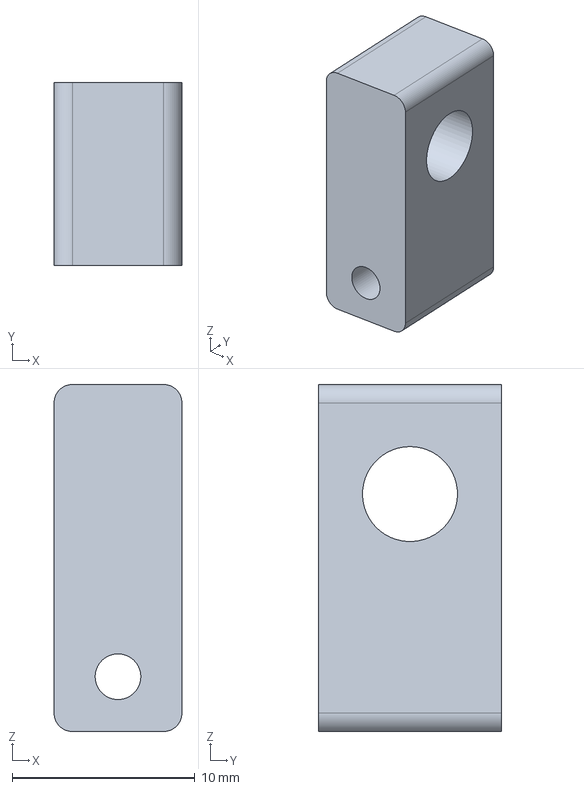
[picture p43: CAD file, 2026-11-01]
pnp/out/parts_step/YTension_Block_1.step
7.00 x 10.0 x 19.0 mm
