gionix38/tevo-bw-pick-and-place/pnp/out/parts_stl/Lane1_Body.stl

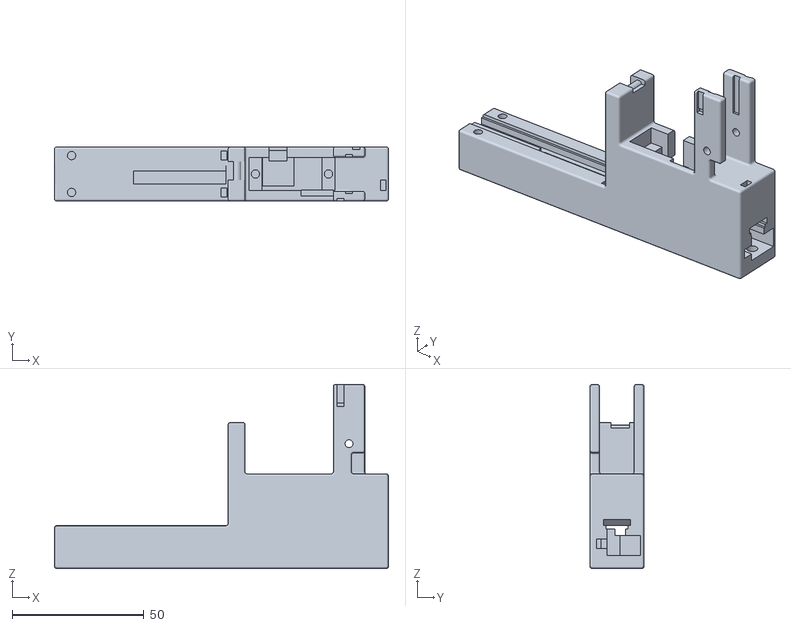
[picture p44: CAD file, 2026-11-01]
pnp/out/parts_stl/Lane1_Body.stl
127.0 x 20.5 x 70.0
