gionix38/tevo-bw-pick-and-place/pnp/feeder/out/stl/SidePlate.stl

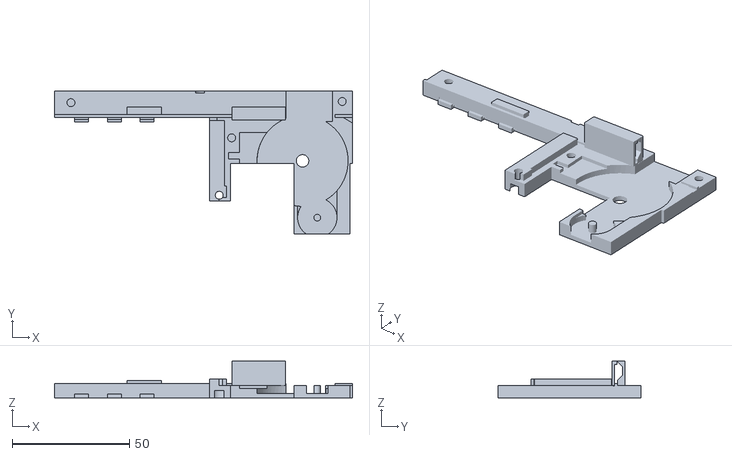
[picture p45: CAD file, 2026-11-01]
pnp/feeder/out/stl/SidePlate.stl
127.0 x 61.0 x 15.8
