gionix38/tevo-bw-pick-and-place/pnp/out/parts_stl/Lane1_HoldPawl.stl

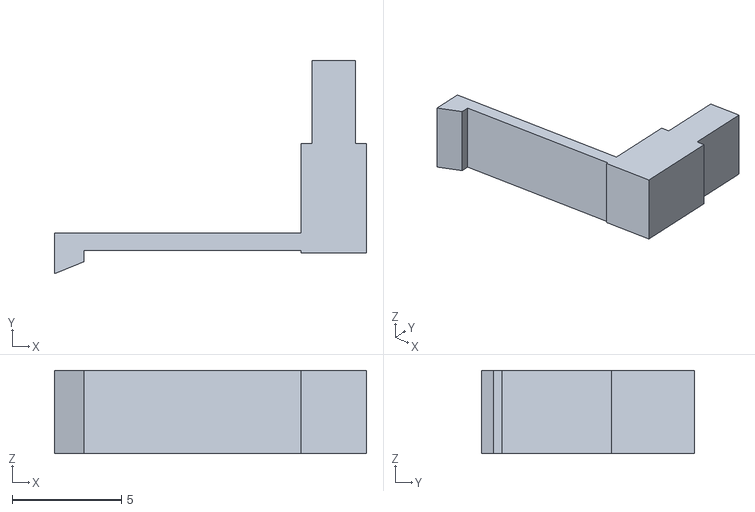
[picture p46: CAD file, 2026-11-01]
pnp/out/parts_stl/Lane1_HoldPawl.stl
14.2 x 9.75 x 3.80
