gionix38/tevo-bw-pick-and-place/pnp/feeder/out/stl/Feeder_WasteBin.stl

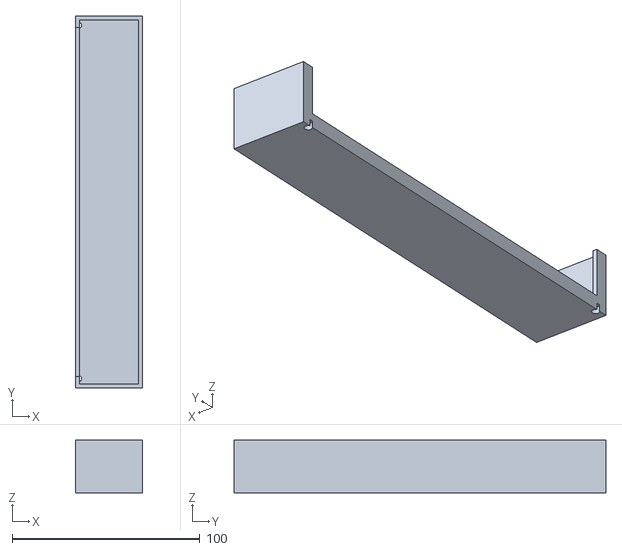
[picture p47: CAD file, 2026-11-01]
pnp/feeder/out/stl/Feeder_WasteBin.stl
35.5 x 198.0 x 28.0
