gionix38/tevo-bw-pick-and-place/pnp/out/parts_step/YMotor_Bracket.step

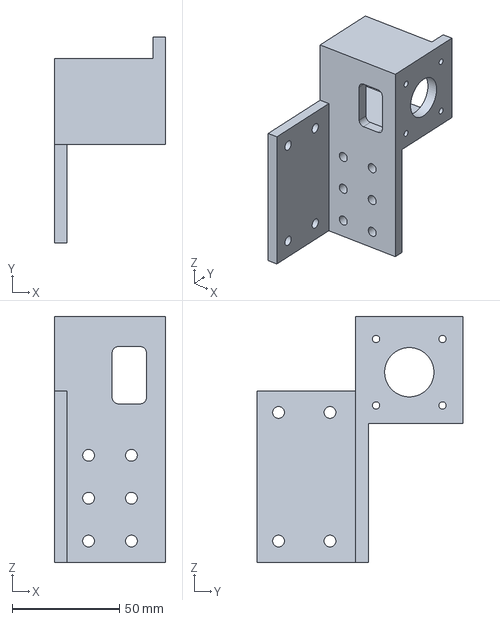
[picture p48: CAD file, 2026-11-01]
pnp/out/parts_step/YMotor_Bracket.step
52.0 x 96.0 x 114.8 mm
