gionix38/tevo-bw-pick-and-place/pnp/out/parts_stl/Lane1_CoverPlate.stl

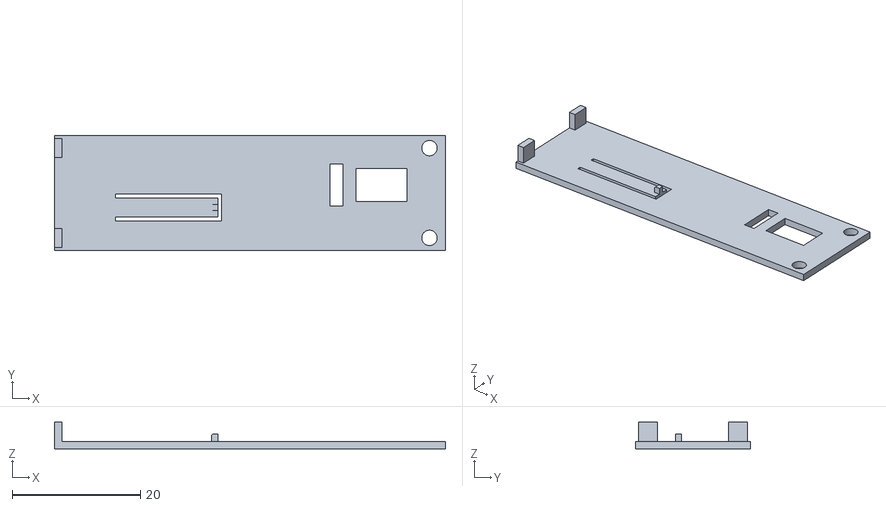
[picture p49: CAD file, 2026-11-01]
pnp/out/parts_stl/Lane1_CoverPlate.stl
61.0 x 18.0 x 4.20
