gionix38/tevo-bw-pick-and-place/pnp/feeder/out/stl/GuideBar.stl

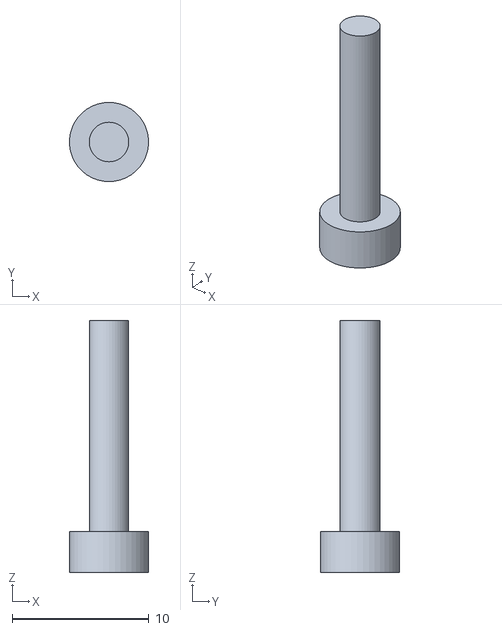
[picture p50: CAD file, 2026-11-01]
pnp/feeder/out/stl/GuideBar.stl
5.78 x 5.80 x 18.5
