gionix38/tevo-bw-pick-and-place/pnp/out/parts_step/Camera_Angle.step

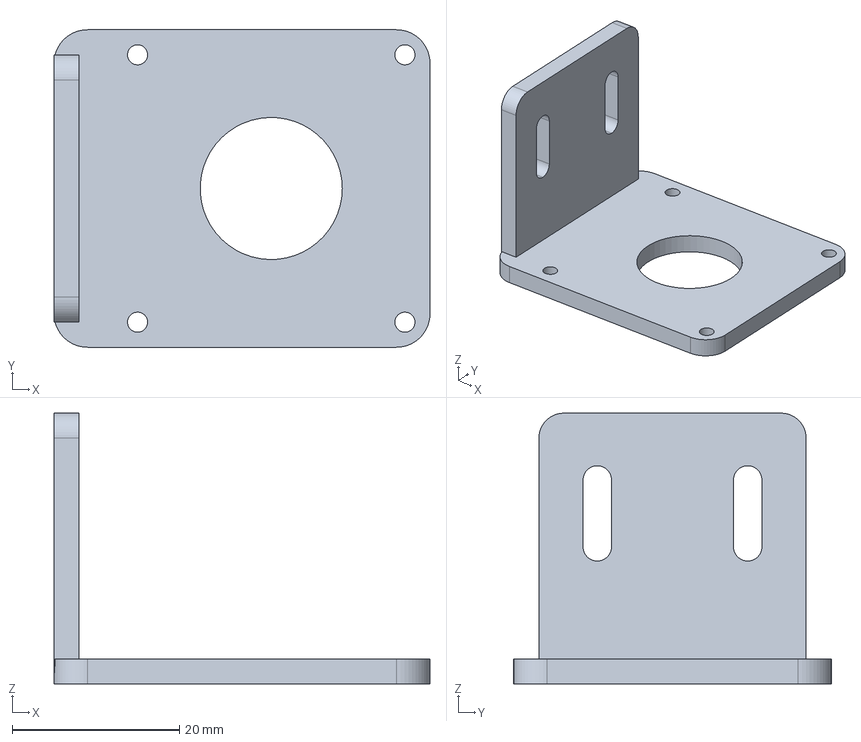
[picture p51: CAD file, 2026-11-01]
pnp/out/parts_step/Camera_Angle.step
45.0 x 38.0 x 32.4 mm
