gionix38/tevo-bw-pick-and-place/pnp/out/parts_stl/Lane1_Ratchet.stl

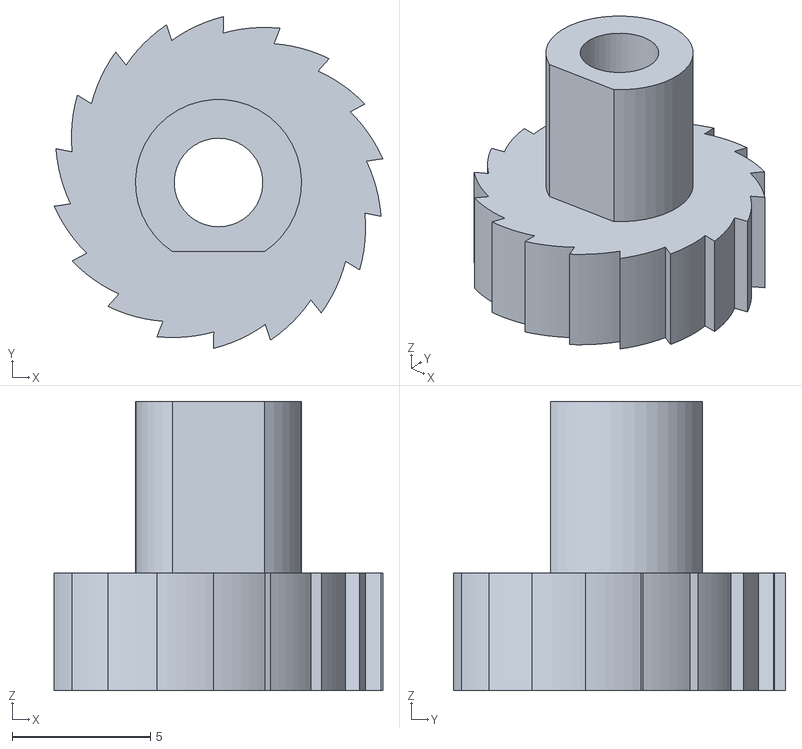
[picture p52: CAD file, 2026-11-01]
pnp/out/parts_stl/Lane1_Ratchet.stl
11.9 x 12.0 x 10.4
