gionix38/tevo-bw-pick-and-place/pnp/feeder/out/stl/Pinion.stl

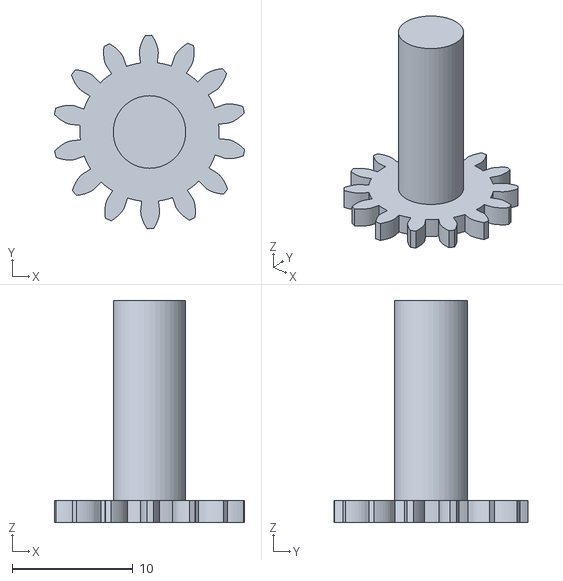
[picture p53: CAD file, 2026-11-01]
pnp/feeder/out/stl/Pinion.stl
15.7 x 16.0 x 18.4
