gionix38/tevo-bw-pick-and-place/pnp/out/parts_step/Z_Slide.step

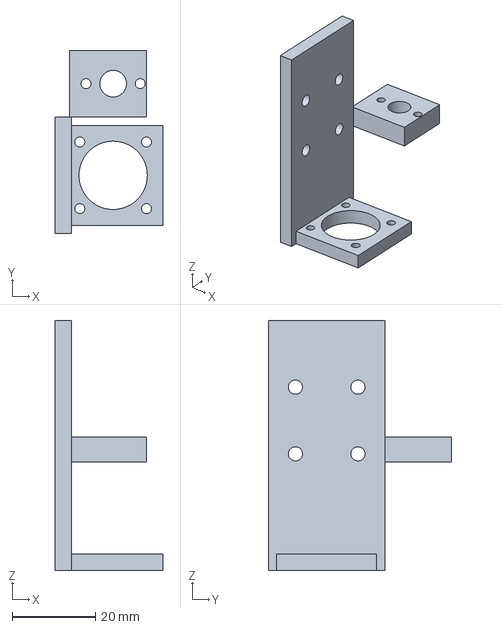
[picture p54: CAD file, 2026-11-01]
pnp/out/parts_step/Z_Slide.step
26.0 x 44.0 x 60.0 mm
