gionix38/tevo-bw-pick-and-place/pnp/out/parts_stl/ReelHub_4.stl

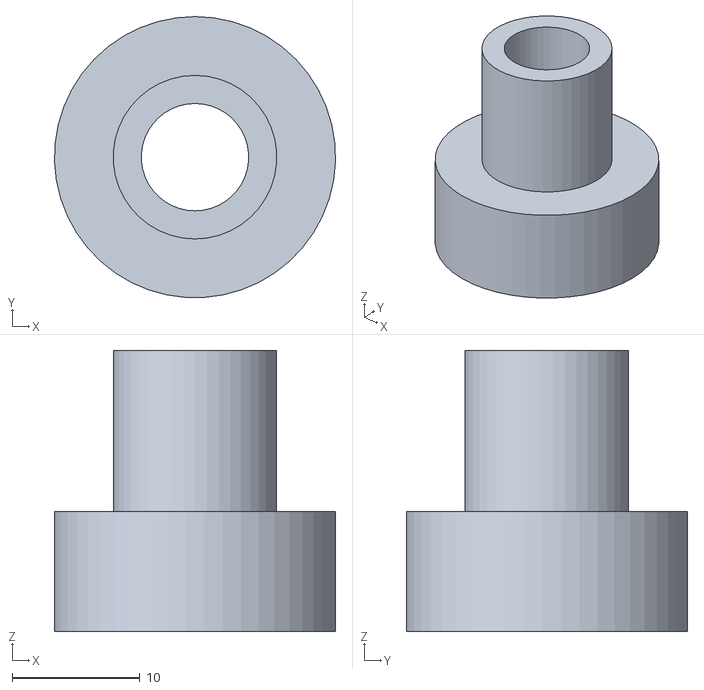
[picture p55: CAD file, 2026-11-01]
pnp/out/parts_stl/ReelHub_4.stl
22.0 x 22.0 x 22.0
