gionix38/tevo-bw-pick-and-place/pnp/feeder/out/stl/Feeder_WasteBinLeg.stl

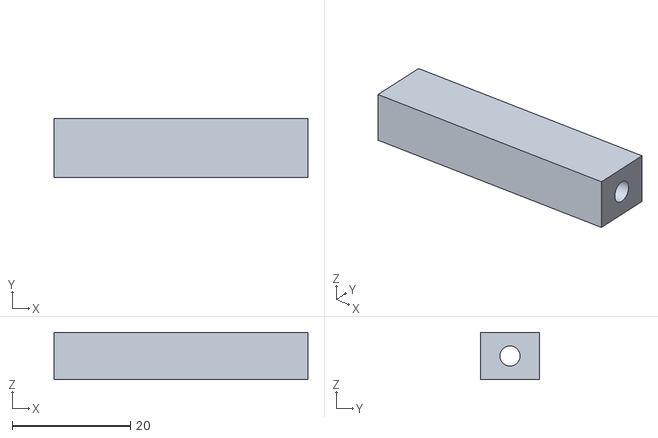
[picture p56: CAD file, 2026-11-01]
pnp/feeder/out/stl/Feeder_WasteBinLeg.stl
43.0 x 10.0 x 8.00
