gionix38/tevo-bw-pick-and-place/pnp/out/parts_stl/Lane1_PinchYoke.stl

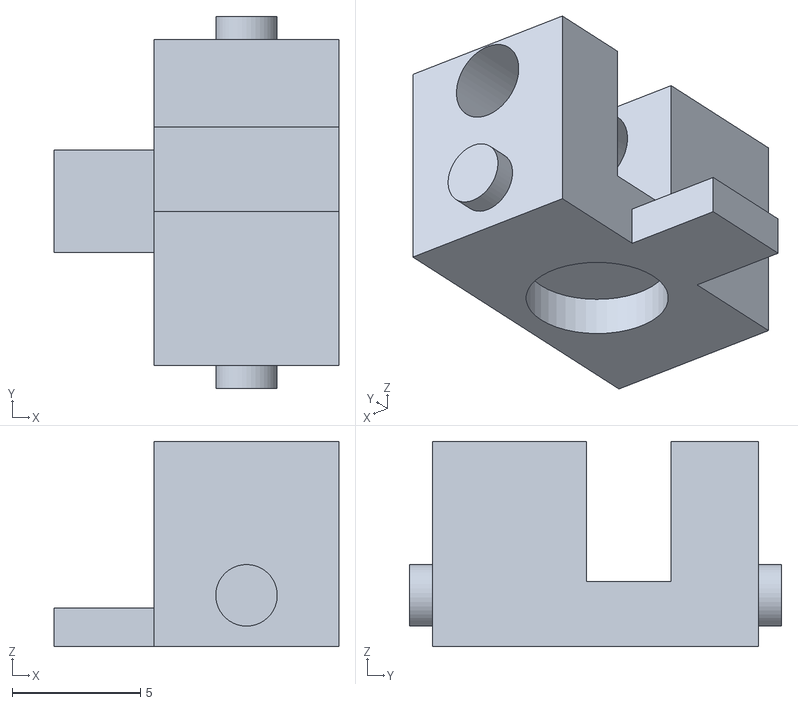
[picture p57: CAD file, 2026-11-01]
pnp/out/parts_stl/Lane1_PinchYoke.stl
11.1 x 14.5 x 8.00
