gionix38/tevo-bw-pick-and-place/pnp/feeder/out/stl/Feeder_ExitChute.stl

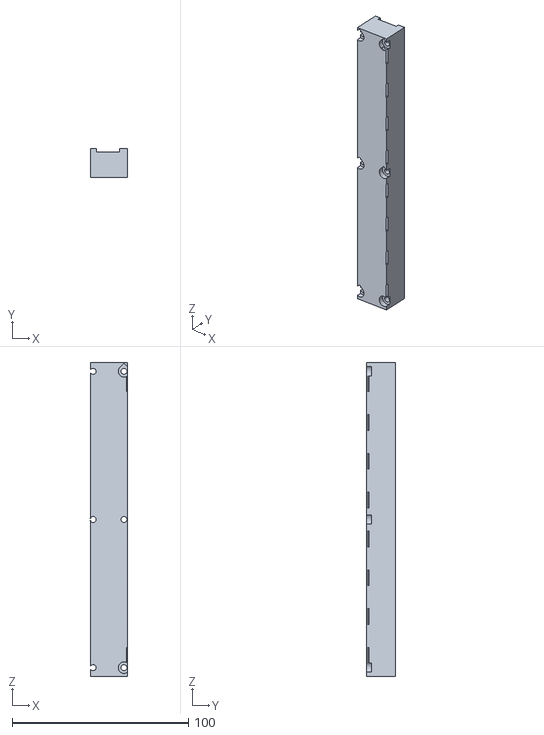
[picture p58: CAD file, 2026-11-01]
pnp/feeder/out/stl/Feeder_ExitChute.stl
21.0 x 16.7 x 178.0
