gionix38/tevo-bw-pick-and-place/pnp/out/parts_stl/Bridge_End_Rear.stl

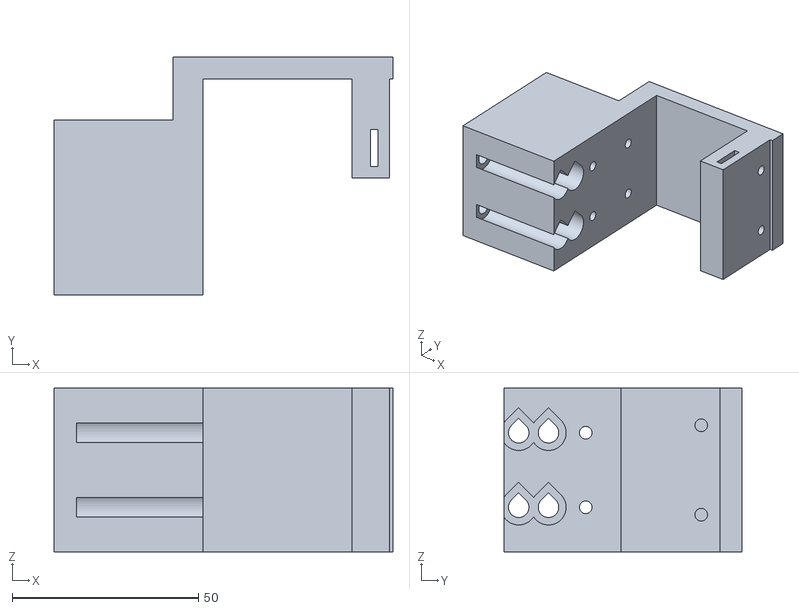
[picture p59: CAD file, 2026-11-01]
pnp/out/parts_stl/Bridge_End_Rear.stl
91.0 x 64.0 x 44.0
