gionix38/tevo-bw-pick-and-place/pnp/feeder/out/stl/DriveRoller.stl

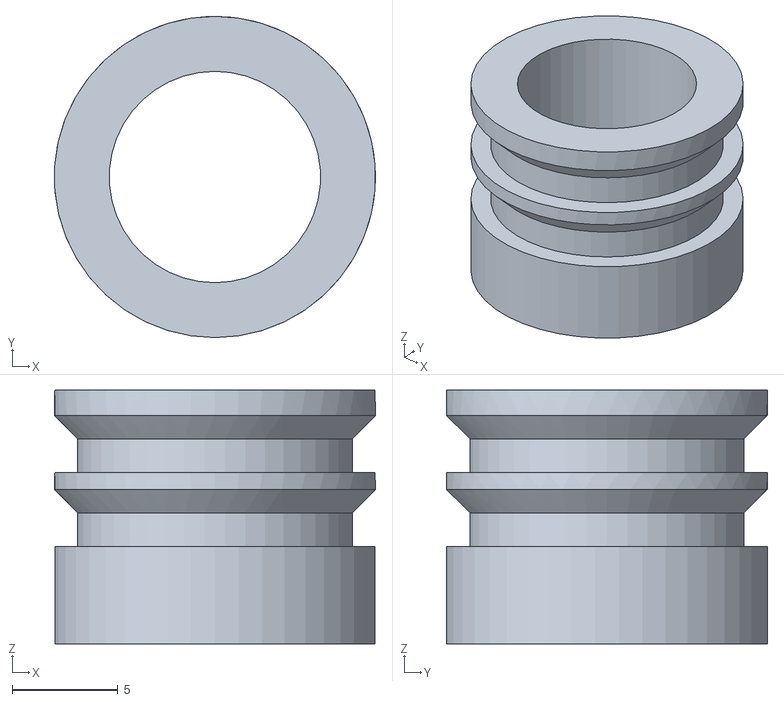
[picture p60: CAD file, 2026-11-01]
pnp/feeder/out/stl/DriveRoller.stl
15.2 x 15.2 x 12.0
