gionix38/tevo-bw-pick-and-place/pnp/feeder/out/stl/Idler.stl

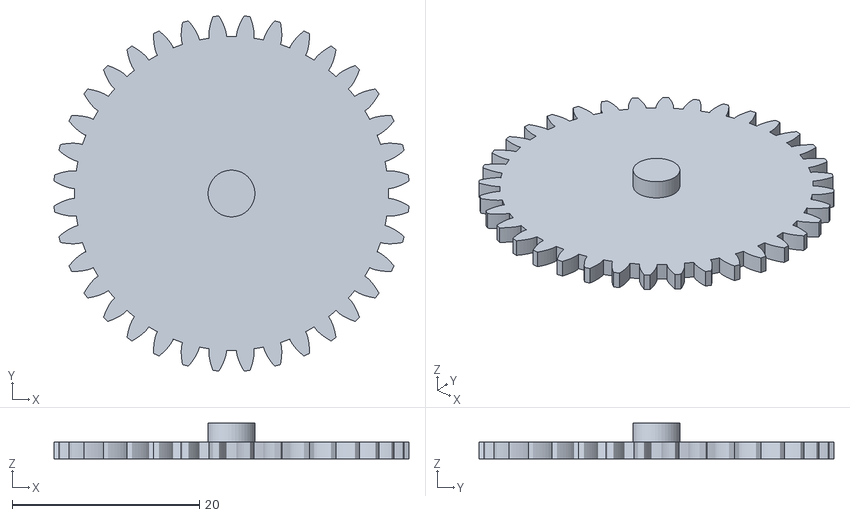
[picture p61: CAD file, 2026-11-01]
pnp/feeder/out/stl/Idler.stl
37.9 x 37.9 x 3.80
