gionix38/tevo-bw-pick-and-place/pnp/feeder/out/stl/Slider.stl

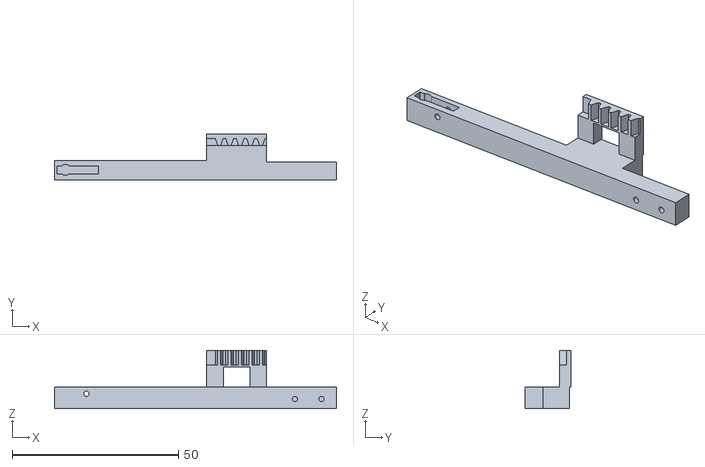
[picture p62: CAD file, 2026-11-01]
pnp/feeder/out/stl/Slider.stl
84.7 x 13.8 x 17.5
