gionix38/tevo-bw-pick-and-place/pnp/out/parts_stl/Corner_FrontRight.stl

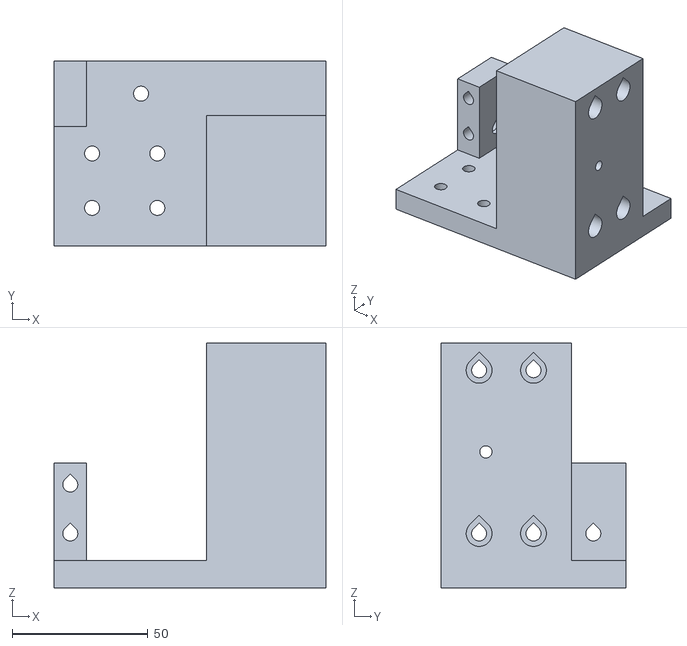
[picture p63: CAD file, 2026-11-01]
pnp/out/parts_stl/Corner_FrontRight.stl
100.0 x 68.0 x 90.0
