gionix38/tevo-bw-pick-and-place/pnp/feeder/out/stl/ServoGear.stl

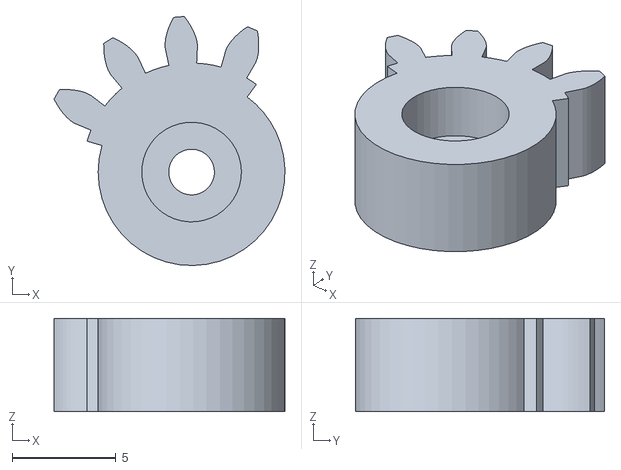
[picture p64: CAD file, 2026-11-01]
pnp/feeder/out/stl/ServoGear.stl
11.1 x 12.0 x 4.50
