gionix38/tevo-bw-pick-and-place/pnp/out/parts_stl/Lane1_Slider.stl

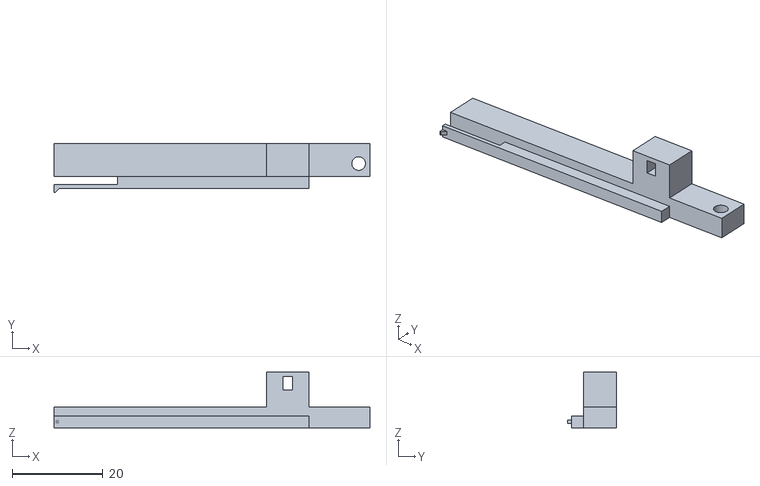
[picture p65: CAD file, 2026-11-01]
pnp/out/parts_stl/Lane1_Slider.stl
69.6 x 10.8 x 12.2
