gionix38/tevo-bw-pick-and-place/pnp/feeder/out/stl/Rack.stl

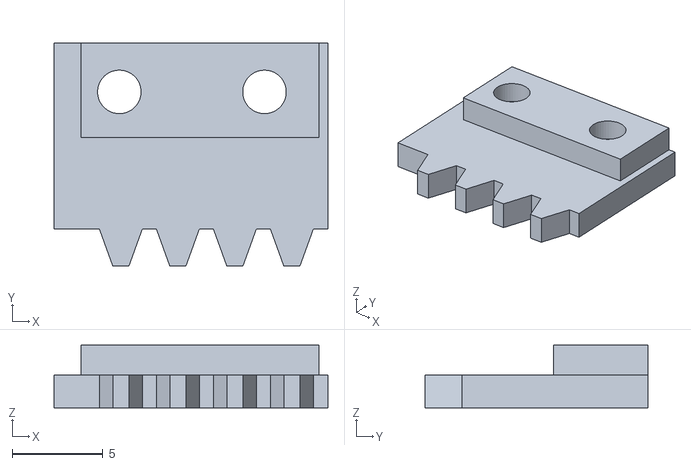
[picture p66: CAD file, 2026-11-01]
pnp/feeder/out/stl/Rack.stl
15.1 x 12.3 x 3.45
