gionix38/tevo-bw-pick-and-place/pnp/feeder/out/stl/Body.stl

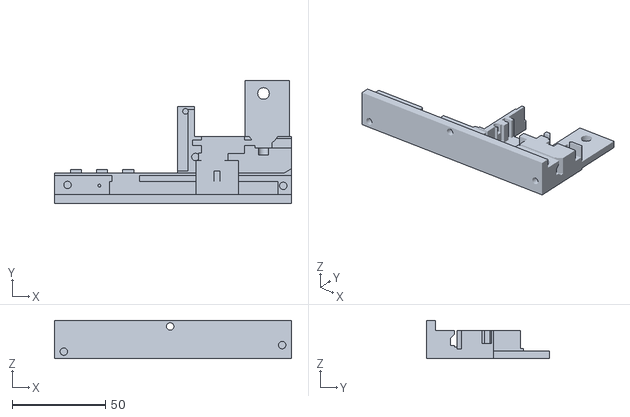
[picture p67: CAD file, 2026-11-01]
pnp/feeder/out/stl/Body.stl
127.0 x 66.0 x 20.5
