gionix38/tevo-bw-pick-and-place/pnp/out/parts_stl/Feeder_WasteBinLeg_2.stl

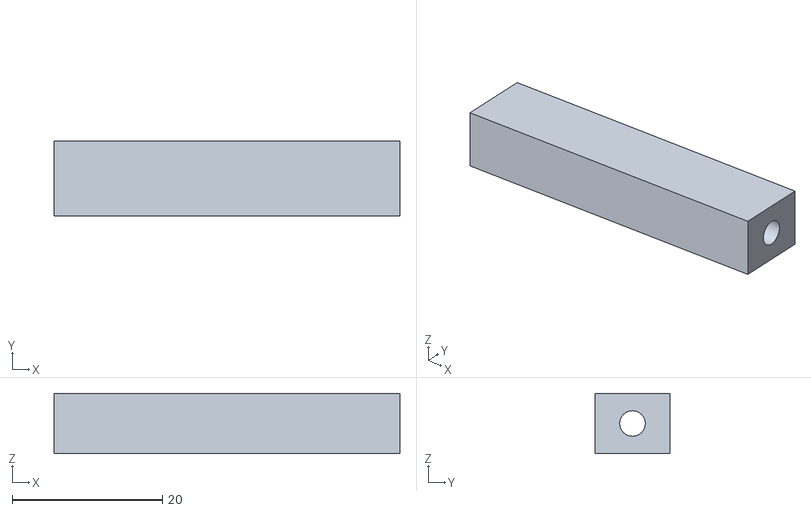
[picture p68: CAD file, 2026-11-01]
pnp/out/parts_stl/Feeder_WasteBinLeg_2.stl
46.0 x 10.0 x 8.00
