gionix38/tevo-bw-pick-and-place/pnp/feeder/out/stl/Pawl.stl

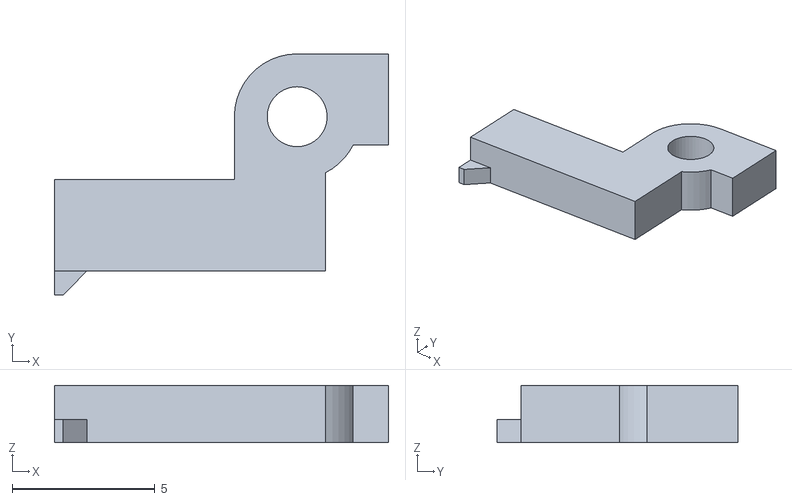
[picture p69: CAD file, 2026-11-01]
pnp/feeder/out/stl/Pawl.stl
11.7 x 8.45 x 2.00
