gionix38/tevo-bw-pick-and-place/pnp/out/parts_stl/XIdler_Slider_Front.stl

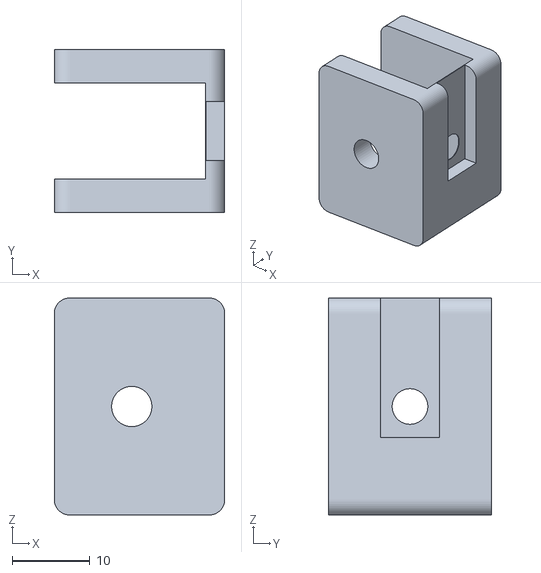
[picture p70: CAD file, 2026-11-01]
pnp/out/parts_stl/XIdler_Slider_Front.stl
22.0 x 21.0 x 28.0
