gionix38/tevo-bw-pick-and-place/pnp/out/parts_stl/XChain_Arm.stl

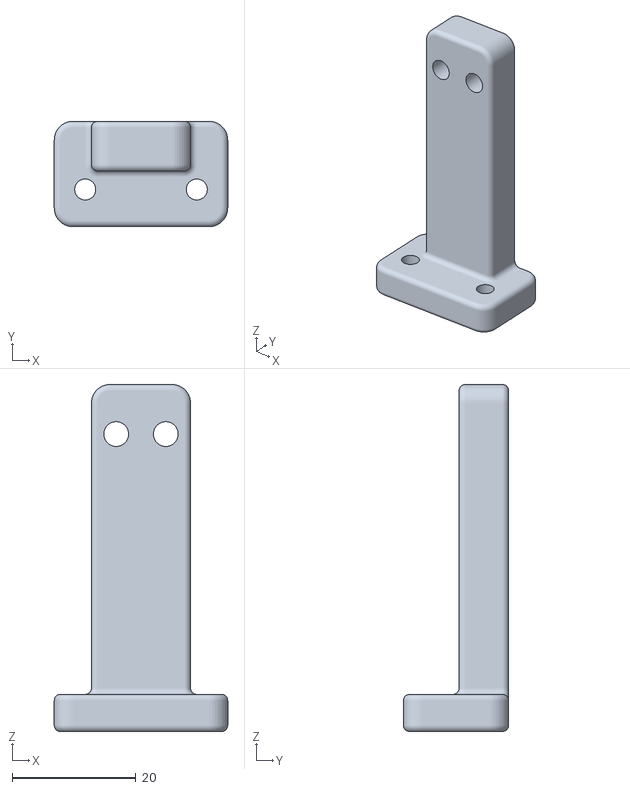
[picture p72: CAD file, 2026-11-01]
pnp/out/parts_stl/XChain_Arm.stl
28.0 x 17.0 x 56.0
