gionix38/tevo-bw-pick-and-place/pnp/out/parts_stl/Feeder_WasteBin.stl

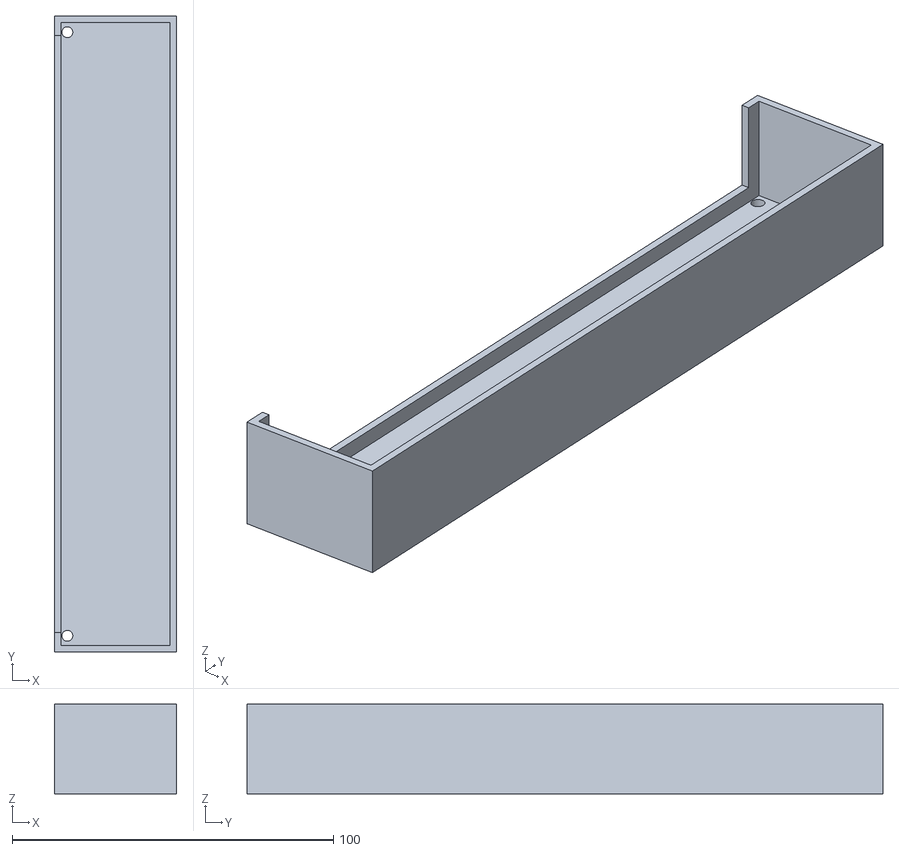
[picture p73: CAD file, 2026-11-01]
pnp/out/parts_stl/Feeder_WasteBin.stl
38.0 x 198.0 x 28.0
