gionix38/tevo-bw-pick-and-place/pnp/out/parts_stl/Corner_FrontLeft.stl

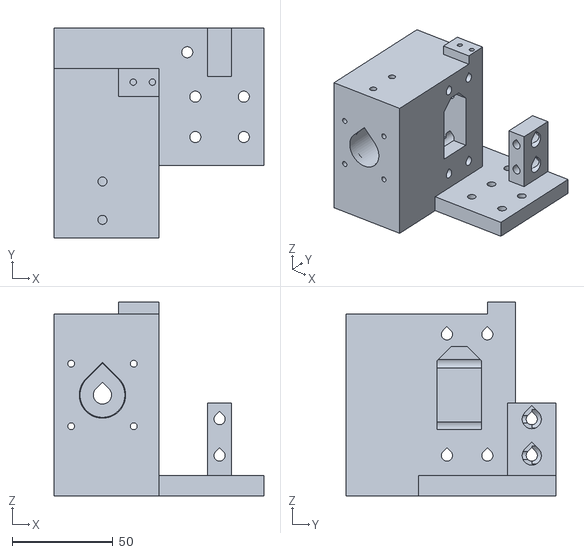
[picture p74: CAD file, 2026-11-01]
pnp/out/parts_stl/Corner_FrontLeft.stl
104.0 x 104.0 x 96.0
