gionix38/tevo-bw-pick-and-place/pnp/out/parts_stl/Head_Carriage.stl

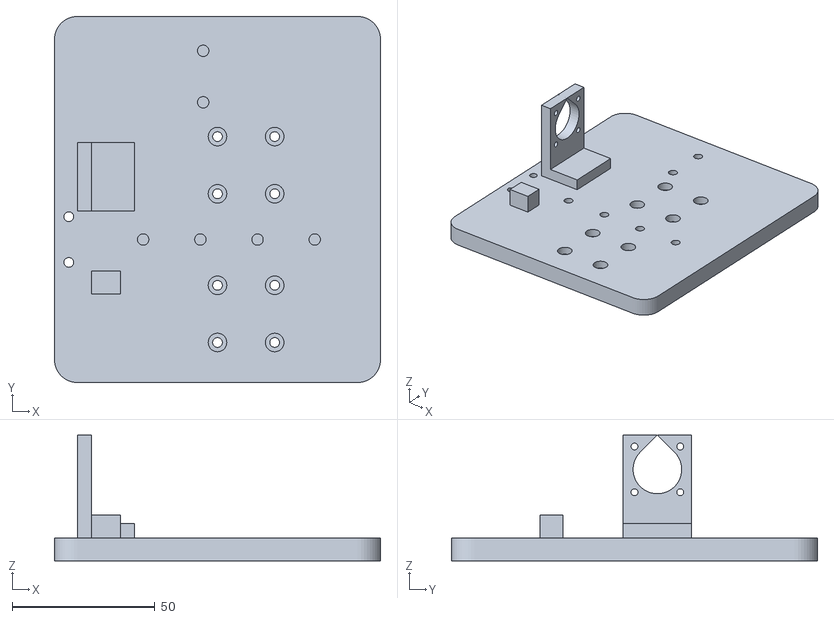
[picture p75: CAD file, 2026-11-01]
pnp/out/parts_stl/Head_Carriage.stl
114.0 x 128.0 x 44.0
