gionix38/tevo-bw-pick-and-place/pnp/out/parts_stl/PCB_SlideClamp.stl

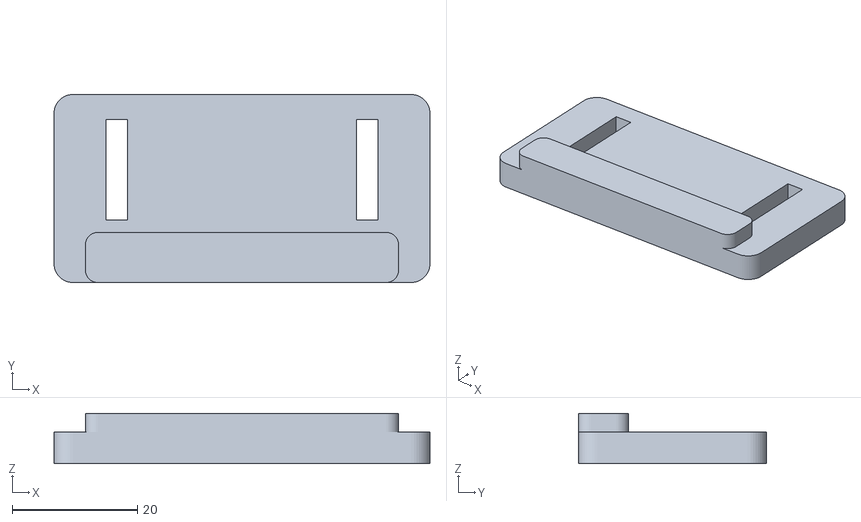
[picture p76: CAD file, 2026-11-01]
pnp/out/parts_stl/PCB_SlideClamp.stl
60.0 x 30.0 x 8.00
