gionix38/tevo-bw-pick-and-place/pnp/out/parts_stl/Lane1_RollerShaft.stl

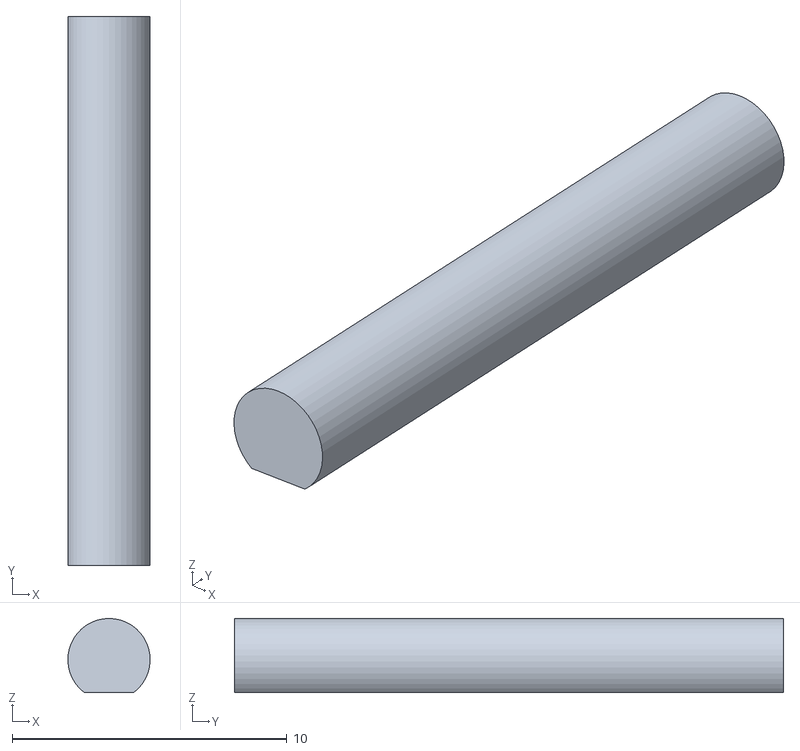
[picture p77: CAD file, 2026-11-01]
pnp/out/parts_stl/Lane1_RollerShaft.stl
3.00 x 20.0 x 2.70
