gionix38/tevo-bw-pick-and-place/pnp/out/parts_stl/Lane1_PinchAxle.stl

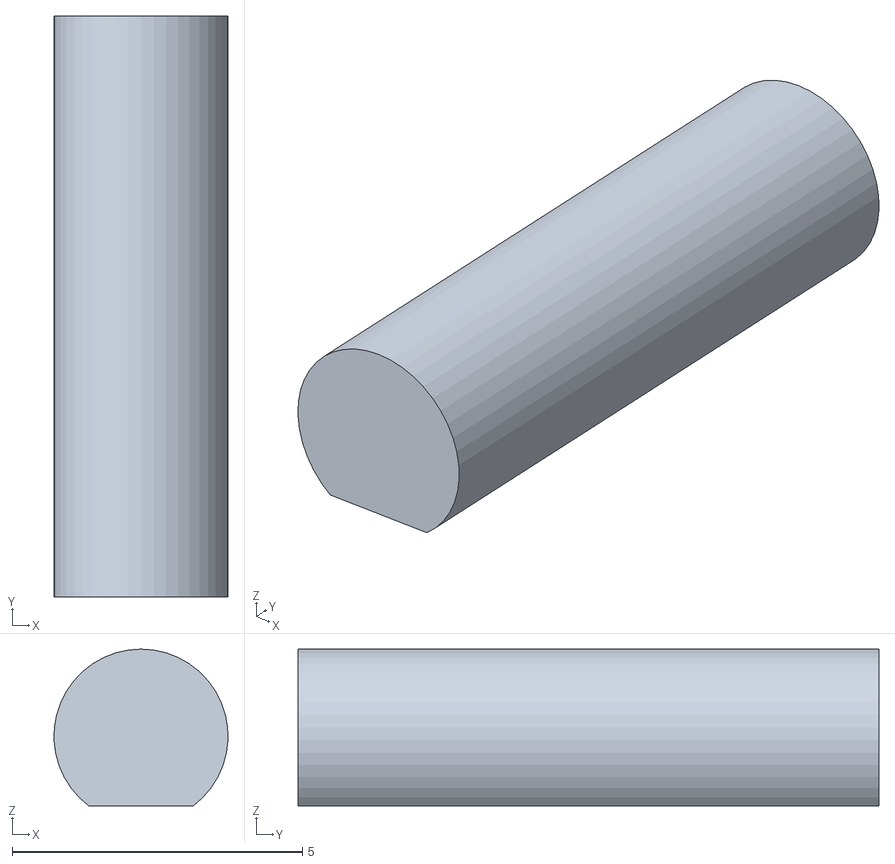
[picture p78: CAD file, 2026-11-01]
pnp/out/parts_stl/Lane1_PinchAxle.stl
3.00 x 10.0 x 2.70
