gionix38/tevo-bw-pick-and-place/pnp/out/parts_stl/Lane1_Lifter.stl

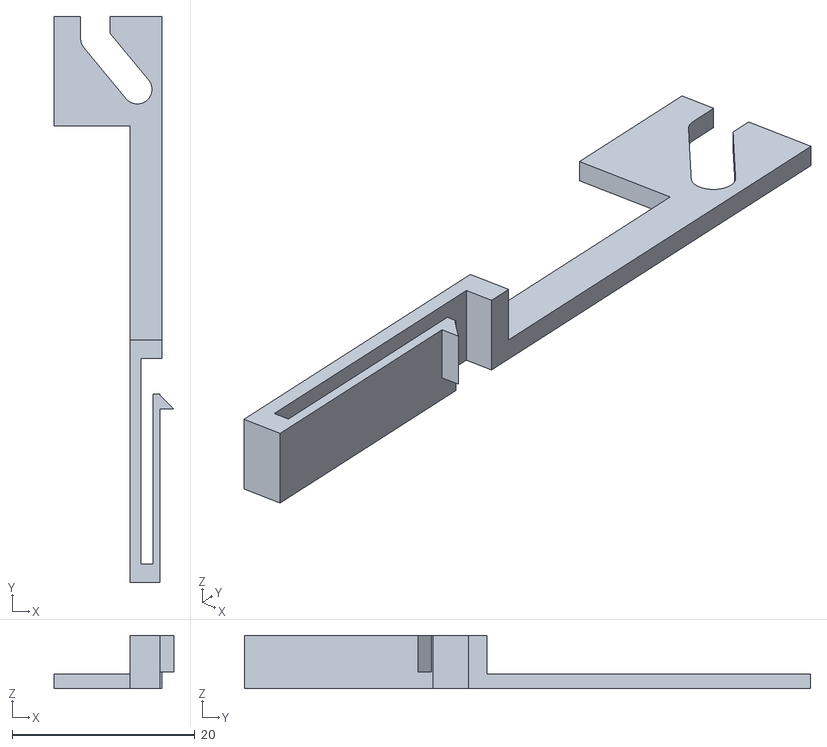
[picture p79: CAD file, 2026-11-01]
pnp/out/parts_stl/Lane1_Lifter.stl
13.1 x 61.9 x 5.80
