gionix38/tevo-bw-pick-and-place/pnp/out/parts_stl/Lane1_SliderPeg.stl

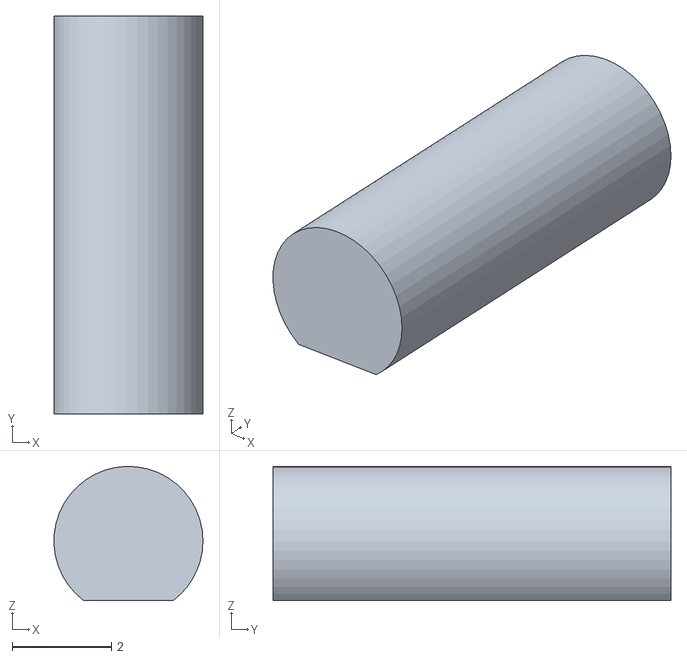
[picture p80: CAD file, 2026-11-01]
pnp/out/parts_stl/Lane1_SliderPeg.stl
3.00 x 8.00 x 2.70
