gionix38/tevo-bw-pick-and-place/pnp/out/parts_stl/Head_BeltClamp.stl

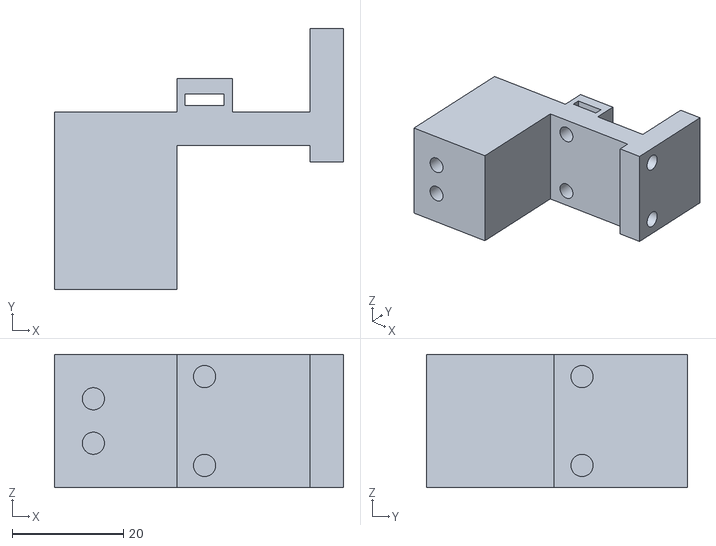
[picture p81: CAD file, 2026-11-01]
pnp/out/parts_stl/Head_BeltClamp.stl
52.0 x 47.0 x 24.0
