gionix38/tevo-bw-pick-and-place/pnp/out/parts_stl/Lane1_DriveRoller.stl

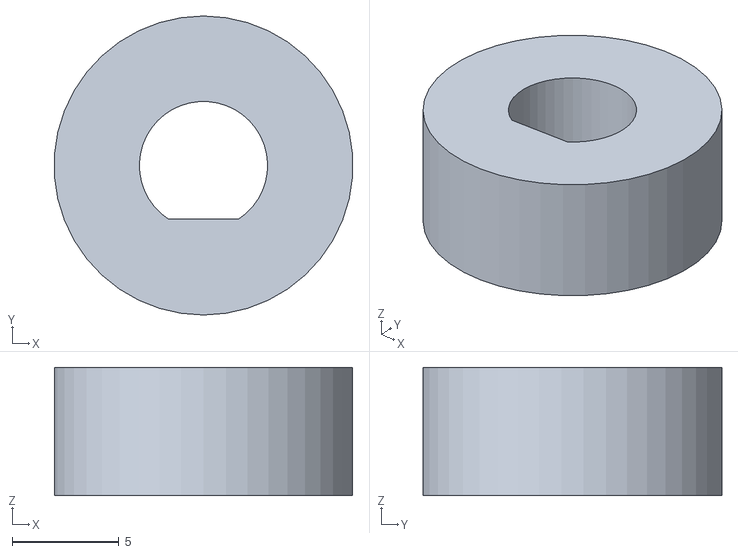
[picture p82: CAD file, 2026-11-01]
pnp/out/parts_stl/Lane1_DriveRoller.stl
14.0 x 14.0 x 6.00
