gionix38/tevo-bw-pick-and-place/(list of files, cad)

Other CAD files:
pnp/out/parts_step/YTension_Block_2.step
pnp/out/parts_stl/XChain_TrayBracket_1.stl
pnp/out/parts_stl/XIdler_Slider_Rear.stl
pnp/out/parts_stl/Corner_RearRight.stl
pnp/out/parts_stl/Bridge_End_Front.stl
pnp/out/parts_stl/ReelHub_8.stl
pnp/out/parts_stl/ReelRack_Side_2.stl
pnp/out/parts_stl/XChain_TrayBracket_2.stl
pnp/out/parts_stl/ReelHub_6.stl
pnp/out/parts_stl/ReelHub_3.stl
pnp/out/parts_stl/ReelHub_7.stl
pnp/feeder/out/tbw_feeder_lane.FCStd
pnp/out/pnp_machine.FCStd
