gionix38/tevo-bw-pick-and-place/pnp/electronics/power_wiring.png

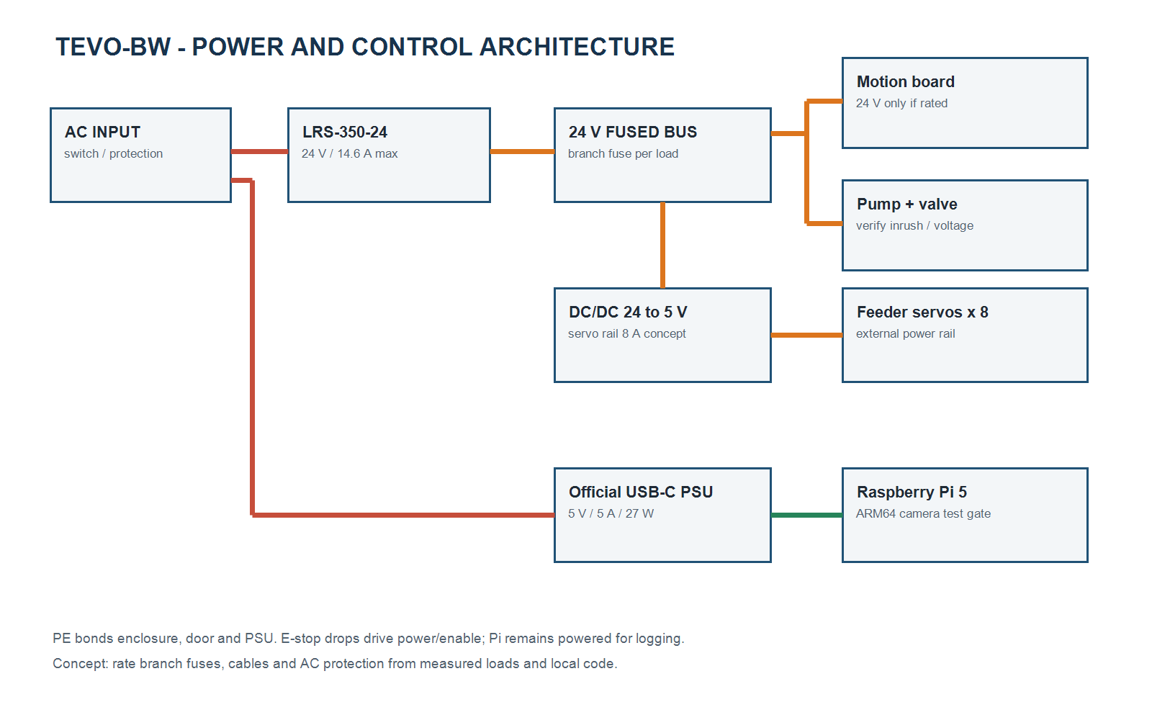
pnp/electronics/power_wiring.png
