gionix38/tevo-bw-pick-and-place/pnp/electronics/wiring_detail.png

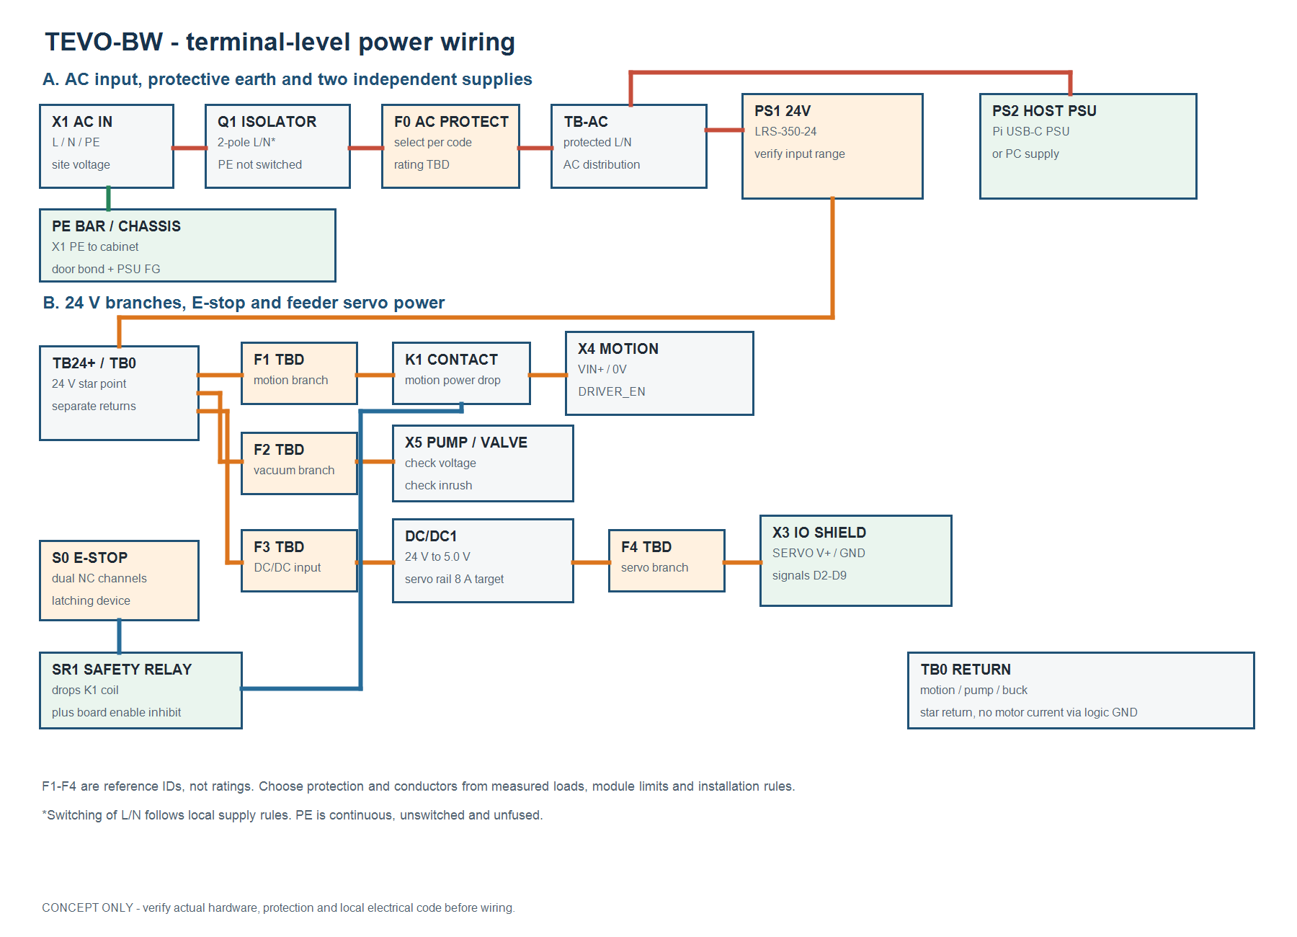
pnp/electronics/wiring_detail.png
